abzman/modular-i2c-board-set/README.md

# modular-i2c-board-set
boards designed to be used together to create a modular control system
