abzman/modular-i2c-board-set/i2c BTS7960/i2c BTS7960.kicad_pcb

## KiCad design i2c BTS7960/i2c BTS7960.kicad_pcb (2024-04-11)

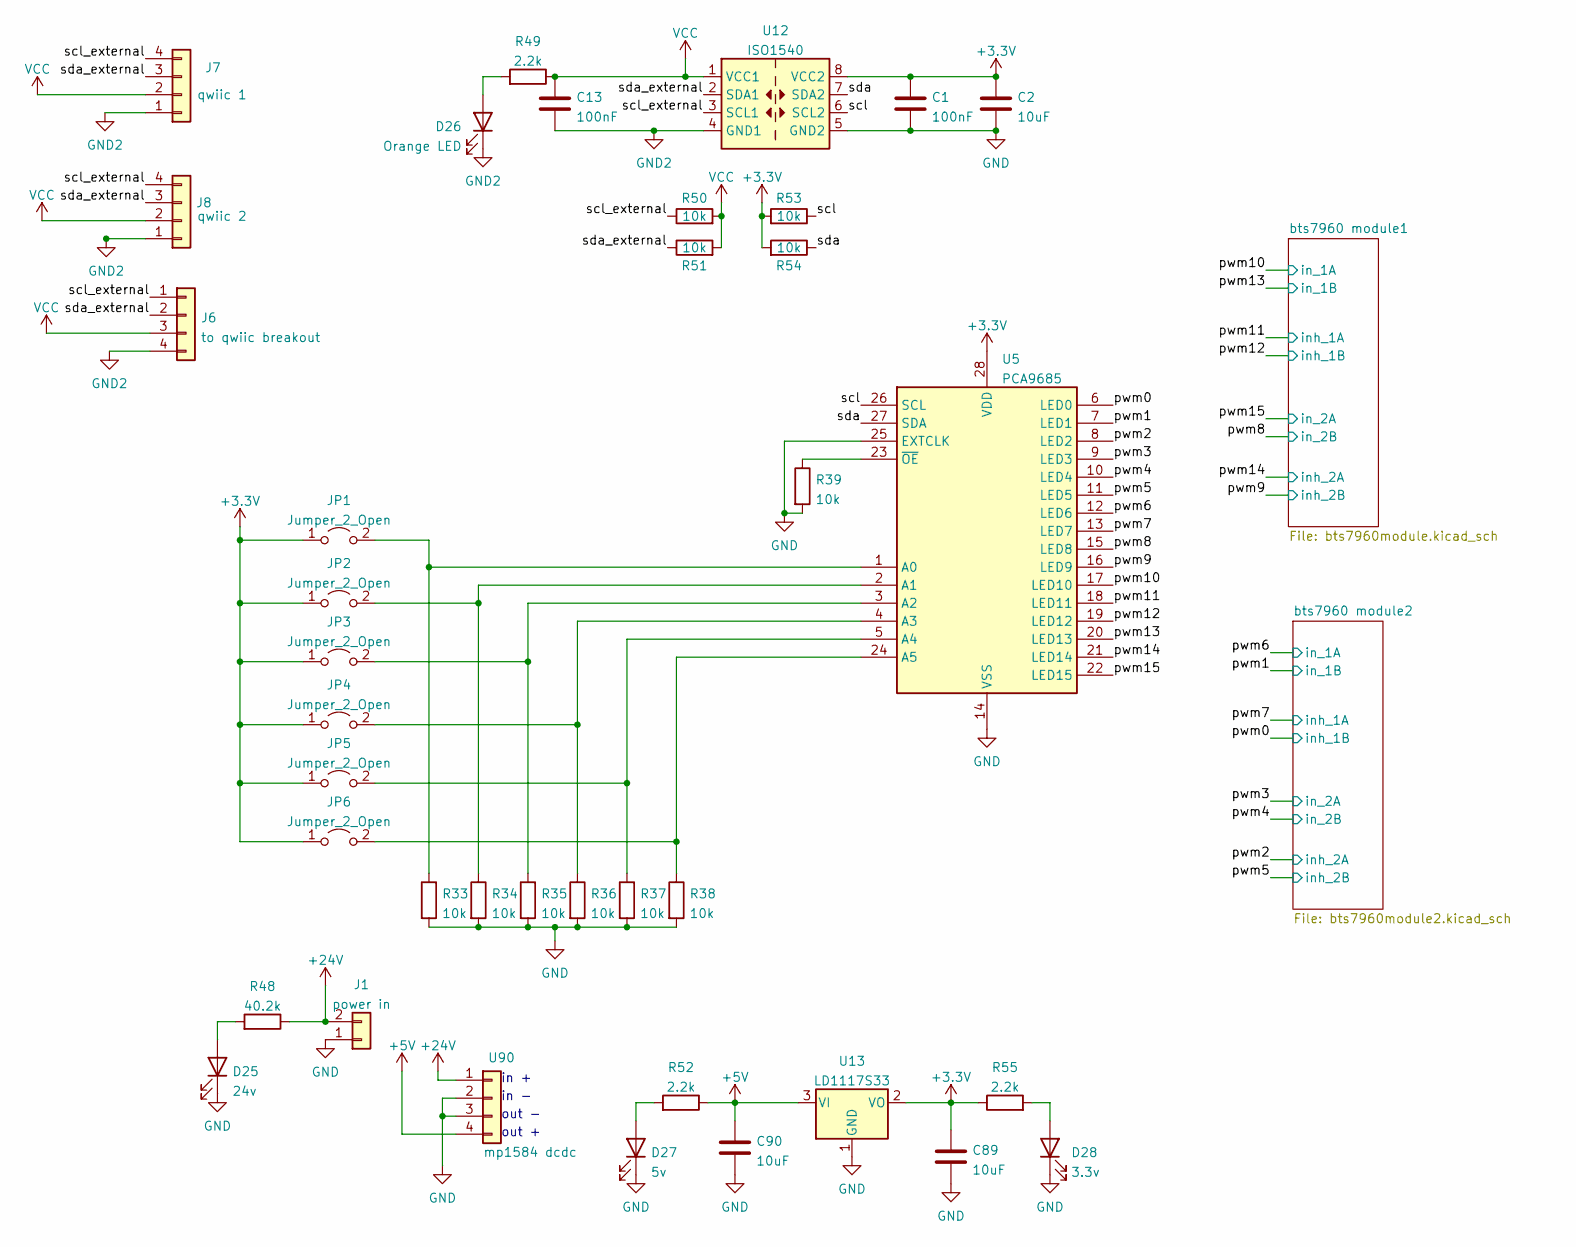
[picture p1: schematic i2c BTS7960.kicad_sch]

Parts:
C1, C13: 100nF; C_0603_1608Metric
C2: 10uF; C_0603_1608Metric
C89, C90: 10uF; C_1206_3216Metric
D25: 24v; LED_0603_1608Metric
D26: Orange LED; LED_0603_1608Metric
D27: 5v; LED_0603_1608Metric
D28: 3.3v; LED_0603_1608Metric
J1: power in; TerminalBlock_Phoenix_MKDS-1,5-2_1x02_P5.00mm_Horizontal
J6: to qwiic breakout; PinHeader_1x04_P2.54mm_Vertical
J7: qwiic 1; JST_SH_SM04B-SRSS-TB_1x04-1MP_P1.00mm_Horizontal
J8: qwiic 2; JST_SH_SM04B-SRSS-TB_1x04-1MP_P1.00mm_Horizontal
JP1, JP2, JP3, JP4, JP5: Jumper_2_Open; SolderJumper-2_P1.3mm_Open_RoundedPad1.0x1.5mm
JP6: Jumper_2_Open; SolderJumper-2_P1.3mm_Bridged_RoundedPad1.0x1.5mm
R33, R34, R35, R36, R37, R38, R39, R50, R51, R53, R54: 10k; R_0603_1608Metric
R48: 40.2k; R_0603_1608Metric
R49, R52, R55: 2.2k; R_0603_1608Metric
U5: PCA9685; TSSOP-28_4.4x9.7mm_P0.65mm
U12: ISO1540; SOIC-8_3.9x4.9mm_P1.27mm
U13: LD1117S33; SOT-223-3_TabPin2
U90: mp1584 dcdc; MP1584_buck_module

Connections:
+3V3: C1.1, C2.1, C89.1, JP1.1 (A), JP2.1 (A), JP3.1 (A), JP4.1 (A), JP5.1 (A), JP6.1 (A), R53.2, R54.2, R55.1, U5.28 (VDD), U12.8 (VCC2), U13.2 (VO)
+5V: C90.1, R52.1, U13.3 (VI), U90.4; also elsewhere on the board
+24V: J1.2, R48.1, U90.1; also elsewhere on the board
/pwm0: U5.6 (LED0); also elsewhere on the board
/pwm1: U5.7 (LED1); also elsewhere on the board
/pwm2: U5.8 (LED2); also elsewhere on the board
/pwm3: U5.9 (LED3); also elsewhere on the board
/pwm4: U5.10 (LED4); also elsewhere on the board
/pwm5: U5.11 (LED5); also elsewhere on the board
/pwm6: U5.12 (LED6); also elsewhere on the board
/pwm7: U5.13 (LED7); also elsewhere on the board
/pwm8: U5.15 (LED8); also elsewhere on the board
/pwm9: U5.16 (LED9); also elsewhere on the board
/pwm10: U5.17 (LED10); also elsewhere on the board
/pwm11: U5.18 (LED11); also elsewhere on the board
/pwm12: U5.19 (LED12); also elsewhere on the board
/pwm13: U5.20 (LED13); also elsewhere on the board
/pwm14: U5.21 (LED14); also elsewhere on the board
/pwm15: U5.22 (LED15); also elsewhere on the board
/scl: R53.1, U5.26 (SCL), U12.6 (SCL2)
/scl_external: J6.1, J7.4, J8.4, R50.1, U12.3 (SCL1)
/sda: R54.1, U5.27 (SDA), U12.7 (SDA2)
/sda_external: J6.2, J7.3, J8.3, R51.1, U12.2 (SDA1)
GND: C1.2, C2.2, C89.2, C90.2, D25.1 (K), D27.1 (K), D28.1 (K), J1.1, J7.MP, J8.MP, R33.2, R34.2, R35.2, R36.2, R37.2, R38.2, R39.2, U5.14 (VSS), U5.25 (EXTCLK), U12.5 (GND2), U13.1 (GND), U90.2, U90.3; also elsewhere on the board
GND2: C13.2, D26.1 (K), J6.4, J7.1, J8.1, U12.4 (GND1)
unnamed: D25.2 (A), R48.2
unnamed: D26.2 (A), R49.2
unnamed: D27.2 (A), R52.2
unnamed: D28.2 (A), R55.2
unnamed: JP1.2 (B), R33.1, U5.1 (A0)
unnamed: JP2.2 (B), R34.1, U5.2 (A1)
unnamed: JP3.2 (B), R35.1, U5.3 (A2)
unnamed: JP4.2 (B), R36.1, U5.4 (A3)
unnamed: JP5.2 (B), R37.1, U5.5 (A4)
unnamed: JP6.2 (B), R38.1, U5.24 (A5)
unnamed: R39.1, U5.23 (~OE)
VCC: C13.1, J6.3, J7.2, J8.2, R49.1, R50.2, R51.2, U12.1 (VCC1)

Notes on the sheet:
in +
out -
out +
in -

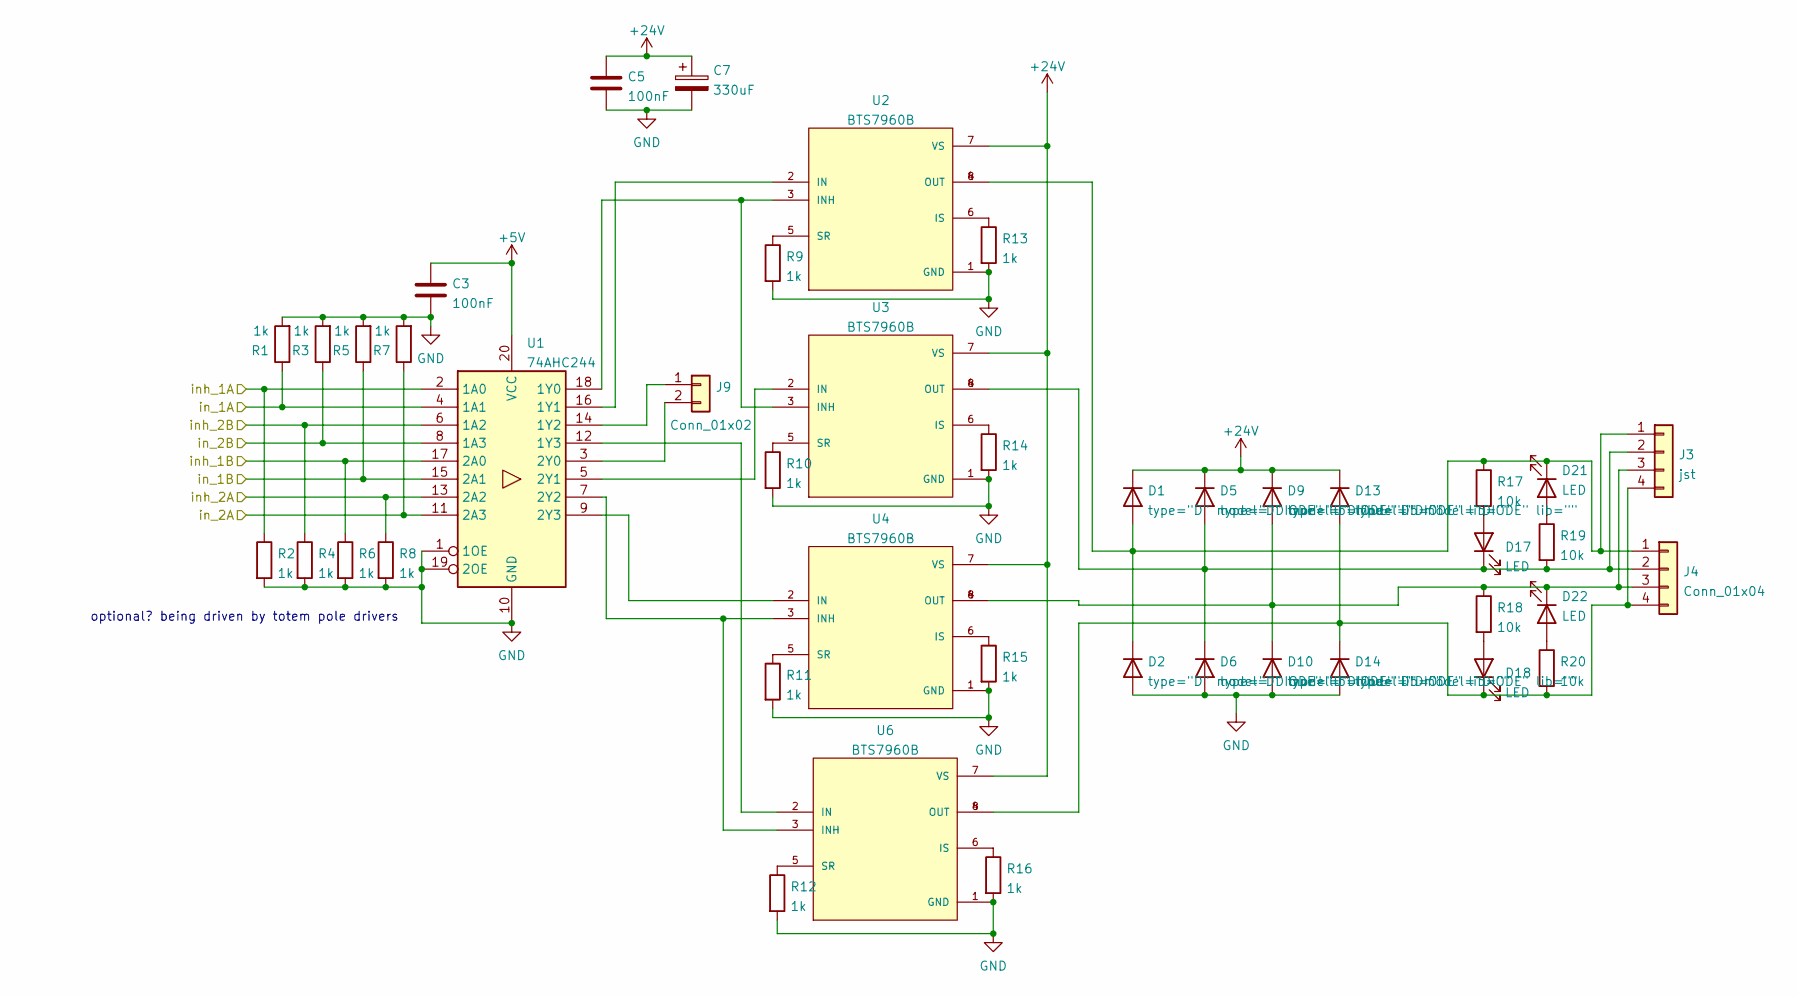
[picture p2: schematic bts7960module2.kicad_sch]

Parts:
C3, C5: 100nF; C_0603_1608Metric
C7: 330uF; CP_Radial_D10.0mm_P5.00mm
D1, D2, D5, D6, D9, D10, D13, D14: type="D" model="DIODE" lib=""; D_SMA
D17, D18, D21, D22: LED; LED_0603_1608Metric
J3: jst; JST_XH_B4B-XH-A_1x04_P2.50mm_Vertical
J4: Conn_01x04; TerminalBlock_Phoenix_MKDS-1,5-4_1x04_P5.00mm_Horizontal
J9: Conn_01x02; PinHeader_2x01_P2.54mm_Vertical
R1, R2, R3, R4, R5, R6, R7, R8, R9, R10, R11, R12, R13, R14, R15, R16: 1k; R_0603_1608Metric
R17, R18, R19, R20: 10k; R_0603_1608Metric
U1: 74AHC244; SOIC-20W_7.5x12.8mm_P1.27mm
U2, U3, U4, U6: BTS7960B; DPAK127P1490X440-8N; PARTREV 1.1

Connections:
+5V: C3.1, U1.20 (VCC); also elsewhere on the board
+24V: C5.1, C7.1, D1.2 (K), D5.2 (K), D9.2 (K), D13.2 (K), U2.7 (VS), U3.7 (VS), U4.7 (VS), U6.7 (VS); also elsewhere on the board
/pwm0: R6.1, U1.17 (2A0); also elsewhere on the board
/pwm1: R5.1, U1.15 (2A1); also elsewhere on the board
/pwm2: R8.1, U1.13 (2A2); also elsewhere on the board
/pwm3: R7.1, U1.11 (2A3); also elsewhere on the board
/pwm4: R3.1, U1.8 (1A3); also elsewhere on the board
/pwm5: R4.1, U1.6 (1A2); also elsewhere on the board
/pwm6: R1.1, U1.4 (1A1); also elsewhere on the board
/pwm7: R2.1, U1.2 (1A0); also elsewhere on the board
GND: C3.2, C5.2, C7.2, D2.1 (A), D6.1 (A), D10.1 (A), D14.1 (A), R1.2, R2.2, R3.2, R4.2, R5.2, R6.2, R7.2, R8.2, R9.2, R10.2, R11.2, R12.2, R13.2, R14.2, R15.2, R16.2, U1.1 (1OE), U1.10 (GND), U1.19 (2OE), U2.1 (GND), U3.1 (GND), U4.1 (GND), U6.1 (GND); also elsewhere on the board
unnamed: D1.1 (A), D2.2 (K), D21.1 (K), J3.1, J4.1, R17.1, U2.4 (OUT), U2.8 (OUT)
unnamed: D9.1 (A), D10.2 (K), D22.1 (K), J3.3, J4.3, R18.1, U4.4 (OUT), U4.8 (OUT)
unnamed: D13.1 (A), D14.2 (K), D18.1 (K), J3.4, J4.4, R20.2, U6.4 (OUT), U6.8 (OUT)
unnamed: D17.2 (A), R17.2
unnamed: D5.1 (A), D6.2 (K), D17.1 (K), J3.2, J4.2, R19.2, U3.4 (OUT), U3.8 (OUT)
unnamed: D18.2 (A), R18.2
unnamed: D21.2 (A), R19.1
unnamed: D22.2 (A), R20.1
unnamed: J9.1, U1.14 (1Y2)
unnamed: J9.2, U1.3 (2Y0)
unnamed: U1.18 (1Y0), U2.3 (INH), U3.3 (INH)
unnamed: U1.16 (1Y1), U2.2 (IN)
unnamed: U1.12 (1Y3), U6.2 (IN)
unnamed: U1.5 (2Y1), U3.2 (IN)
unnamed: U1.7 (2Y2), U4.3 (INH), U6.3 (INH)
unnamed: U1.9 (2Y3), U4.2 (IN)
unnamed: R13.1, U2.6 (IS)
unnamed: R9.1, U2.5 (SR)
unnamed: R14.1, U3.6 (IS)
unnamed: R10.1, U3.5 (SR)
unnamed: R15.1, U4.6 (IS)
unnamed: R11.1, U4.5 (SR)
unnamed: R16.1, U6.6 (IS)
unnamed: R12.1, U6.5 (SR)

Notes on the sheet:
optional? being driven by totem pole drivers

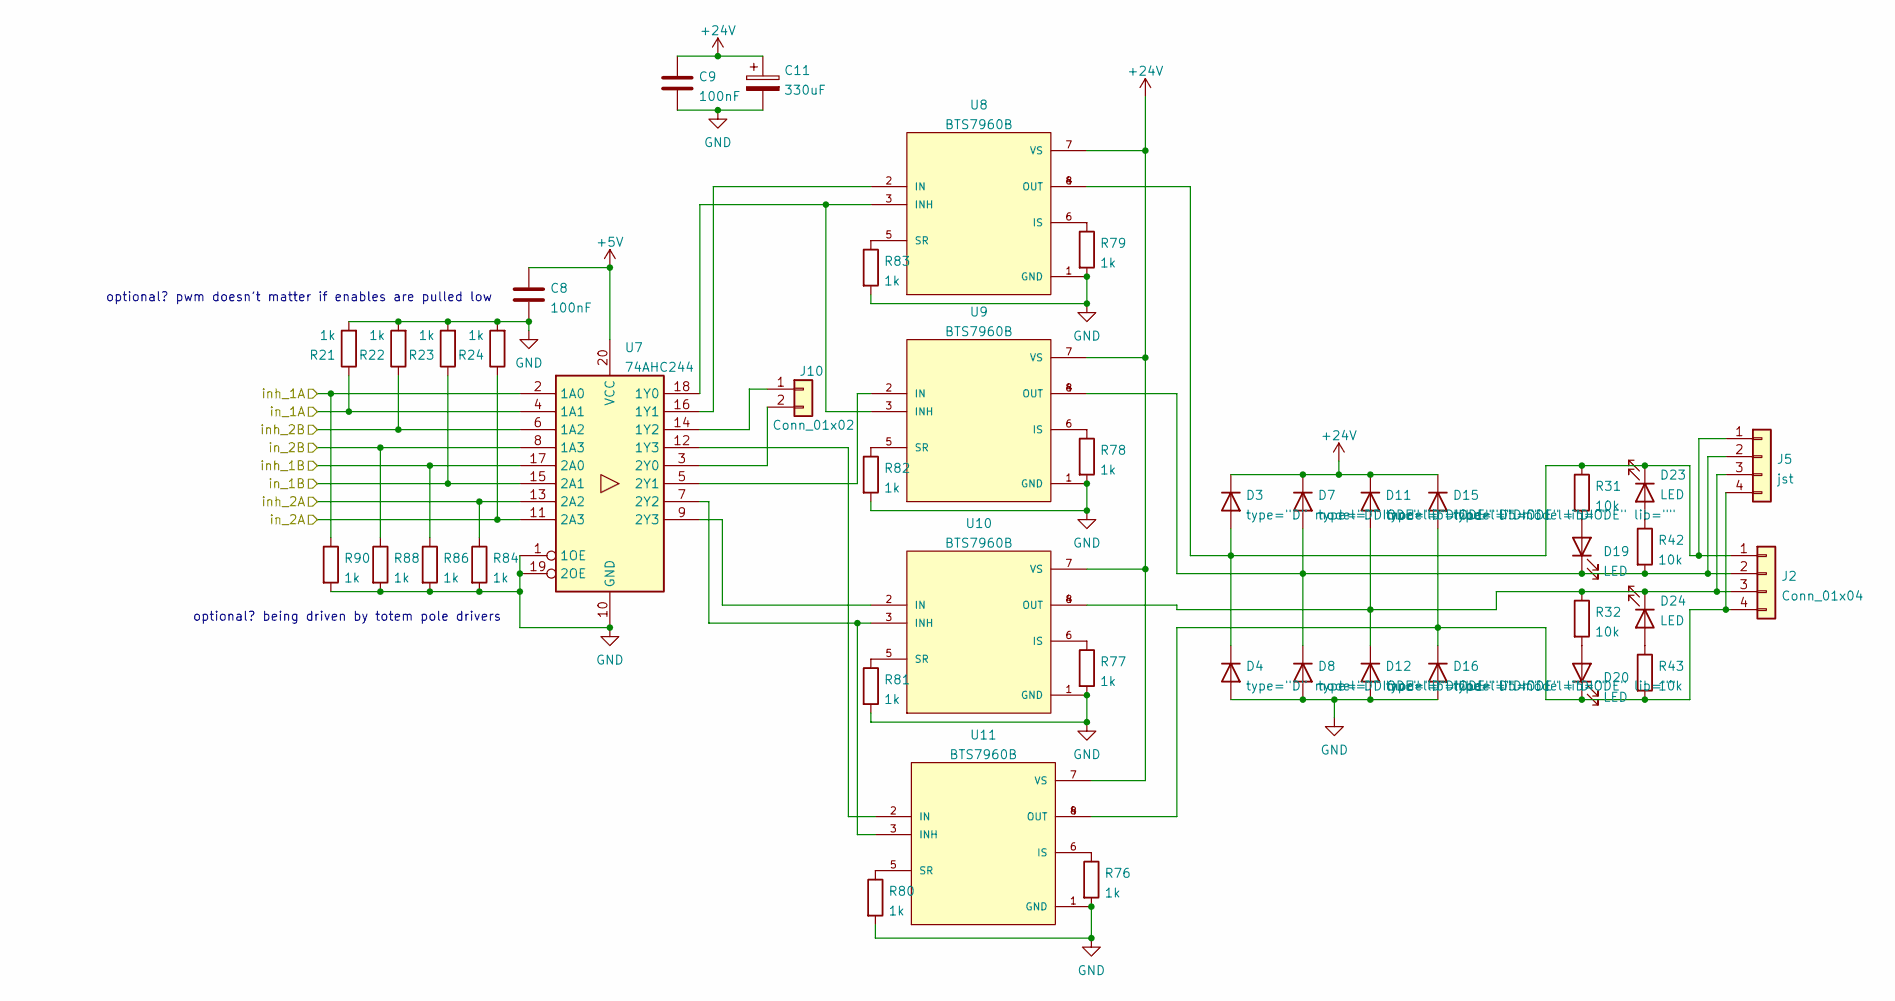
[picture p3: schematic bts7960module.kicad_sch]

Parts:
C8, C9: 100nF; C_0603_1608Metric
C11: 330uF; CP_Radial_D10.0mm_P5.00mm
D3, D4, D7, D8, D11, D12, D15, D16: type="D" model="DIODE" lib=""; D_SMA
D19, D20, D23, D24: LED; LED_0603_1608Metric
J2: Conn_01x04; TerminalBlock_Phoenix_MKDS-1,5-4_1x04_P5.00mm_Horizontal
J5: jst; JST_XH_B4B-XH-A_1x04_P2.50mm_Vertical
J10: Conn_01x02; PinHeader_2x01_P2.54mm_Vertical
R21, R22, R23, R24, R76, R77, R78, R79, R80, R81, R82, R83, R84, R86, R88, R90: 1k; R_0603_1608Metric
R31, R32, R42, R43: 10k; R_0603_1608Metric
U7: 74AHC244; SOIC-20W_7.5x12.8mm_P1.27mm
U8, U9, U10, U11: BTS7960B; DPAK127P1490X440-8N; PARTREV 1.1

Connections:
+5V: C8.1, U7.20 (VCC); also elsewhere on the board
+24V: C9.1, C11.1, D3.2 (K), D7.2 (K), D11.2 (K), D15.2 (K), U8.7 (VS), U9.7 (VS), U10.7 (VS), U11.7 (VS); also elsewhere on the board
/pwm8: R88.1, U7.8 (1A3); also elsewhere on the board
/pwm9: R22.1, U7.6 (1A2); also elsewhere on the board
/pwm10: R21.1, U7.4 (1A1); also elsewhere on the board
/pwm11: R90.1, U7.2 (1A0); also elsewhere on the board
/pwm12: R86.1, U7.17 (2A0); also elsewhere on the board
/pwm13: R23.1, U7.15 (2A1); also elsewhere on the board
/pwm14: R84.1, U7.13 (2A2); also elsewhere on the board
/pwm15: R24.1, U7.11 (2A3); also elsewhere on the board
GND: C8.2, C9.2, C11.2, D4.1 (A), D8.1 (A), D12.1 (A), D16.1 (A), R21.2, R22.2, R23.2, R24.2, R76.2, R77.2, R78.2, R79.2, R80.2, R81.2, R82.2, R83.2, R84.2, R86.2, R88.2, R90.2, U7.1 (1OE), U7.10 (GND), U7.19 (2OE), U8.1 (GND), U9.1 (GND), U10.1 (GND), U11.1 (GND); also elsewhere on the board
unnamed: D11.1 (A), D12.2 (K), D24.1 (K), J2.3, J5.3, R32.1, U10.4 (OUT), U10.8 (OUT)
unnamed: D15.1 (A), D16.2 (K), D20.1 (K), J2.4, J5.4, R43.2, U11.4 (OUT), U11.8 (OUT)
unnamed: D19.2 (A), R31.2
unnamed: D7.1 (A), D8.2 (K), D19.1 (K), J2.2, J5.2, R42.2, U9.4 (OUT), U9.8 (OUT)
unnamed: D20.2 (A), R32.2
unnamed: D23.2 (A), R42.1
unnamed: D3.1 (A), D4.2 (K), D23.1 (K), J2.1, J5.1, R31.1, U8.4 (OUT), U8.8 (OUT)
unnamed: D24.2 (A), R43.1
unnamed: J10.1, U7.14 (1Y2)
unnamed: J10.2, U7.3 (2Y0)
unnamed: U7.18 (1Y0), U8.3 (INH), U9.3 (INH)
unnamed: U7.16 (1Y1), U8.2 (IN)
unnamed: U7.5 (2Y1), U9.2 (IN)
unnamed: R79.1, U8.6 (IS)
unnamed: R83.1, U8.5 (SR)
unnamed: R78.1, U9.6 (IS)
unnamed: R82.1, U9.5 (SR)
unnamed: U7.9 (2Y3), U10.2 (IN)
unnamed: U7.7 (2Y2), U10.3 (INH), U11.3 (INH)
unnamed: R77.1, U10.6 (IS)
unnamed: R81.1, U10.5 (SR)
unnamed: U7.12 (1Y3), U11.2 (IN)
unnamed: R76.1, U11.6 (IS)
unnamed: R80.1, U11.5 (SR)

Notes on the sheet:
optional? pwm doesn't matter if enables are pulled low
optional? being driven by totem pole drivers

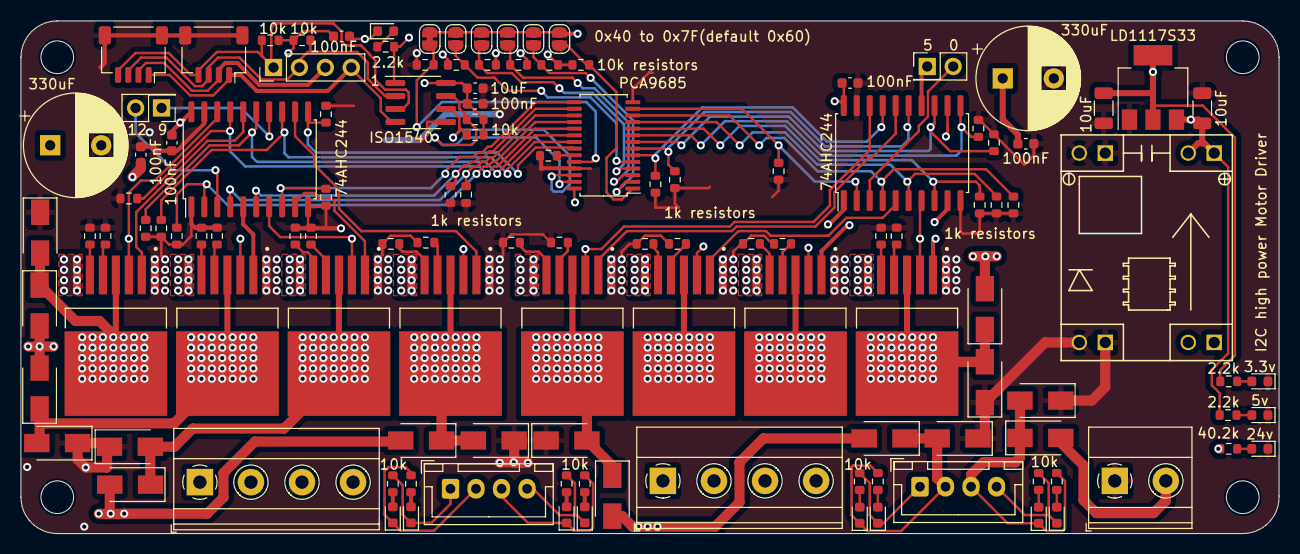
[picture p4: board i2c BTS7960.kicad_pcb from above]

Board: 4 copper layers, 123.2 x 50.2 mm, 124 parts (0 on the bottom side), 85 nets.
