abzman/modular-i2c-board-set/i2c 24vout/i2c 24vout.kicad_pcb

## KiCad design i2c 24vout/i2c 24vout.kicad_pcb (2024-04-10)

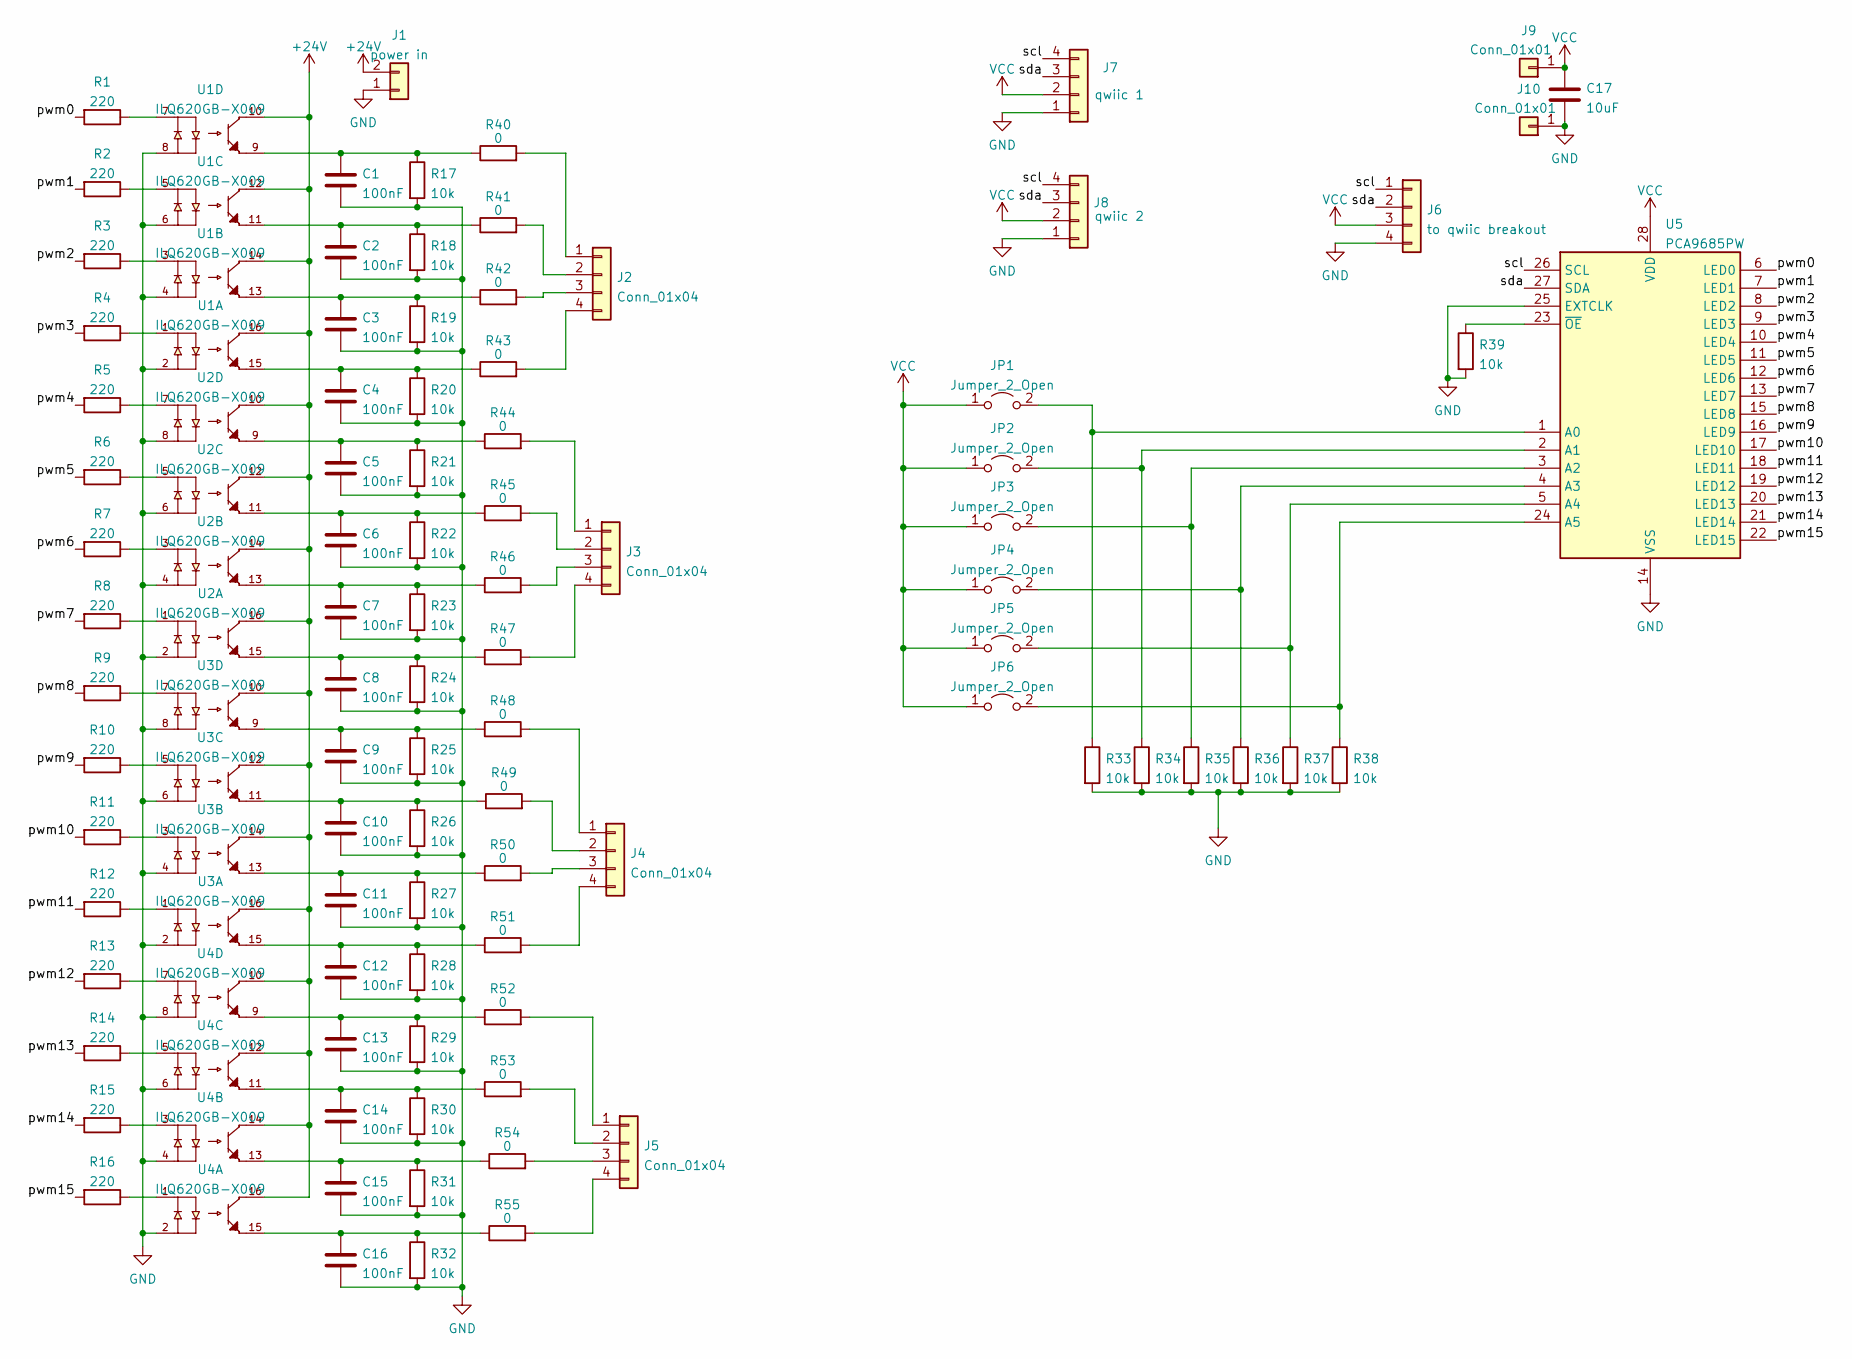
[picture p5: schematic i2c 24vout.kicad_sch]

Parts:
C1, C2, C3, C4, C5, C6, C7, C8, C9, C10, C11, C12, C13, C14, C15, C16: 100nF; C_0603_1608Metric
C17: 10uF; C_0603_1608Metric
J1: power in; TerminalBlock_Phoenix_MKDS-1,5-2_1x02_P5.00mm_Horizontal
J2, J3, J4, J5: Conn_01x04; TerminalBlock_Phoenix_MKDS-1,5-4_1x04_P5.00mm_Horizontal
J6: to qwiic breakout; PinHeader_1x04_P2.54mm_Vertical
J7: qwiic 1; JST_SH_SM04B-SRSS-TB_1x04-1MP_P1.00mm_Horizontal
J8: qwiic 2; JST_SH_SM04B-SRSS-TB_1x04-1MP_P1.00mm_Horizontal
J9, J10: Conn_01x01; PinHeader_1x01_P2.54mm_Vertical
JP1, JP2, JP3, JP4, JP5, JP6: Jumper_2_Open; SolderJumper-2_P1.3mm_Open_RoundedPad1.0x1.5mm
R1, R2, R3, R4, R5, R6, R7, R8, R9, R10, R11, R12, R13, R14, R15, R16: 220; R_0603_1608Metric
R17, R18, R19, R20, R21, R22, R23, R24, R25, R26, R27, R28, R29, R30, R31, R32, R33, R34, R35, R36, R37, R38, R39: 10k; R_0603_1608Metric
R40, R41, R42, R43, R44, R45, R46, R47, R48, R49, R50, R51, R52, R53, R54, R55: 0; R_0603_1608Metric
U1, U2, U3, U4: ILQ620GB-X009; OPTO_ILQ620GB-X009; PARTREV 1.8
U5: PCA9685PW; TSSOP-28_4.4x9.7mm_P0.65mm

Connections:
+24V: J1.2, U1.10, U1.12, U1.14, U1.16, U2.10, U2.12, U2.14, U2.16, U3.10, U3.12, U3.14, U3.16, U4.10, U4.12, U4.14, U4.16
/pwm0: R1.2, U5.6 (LED0)
/pwm1: R2.2, U5.7 (LED1)
/pwm2: R3.2, U5.8 (LED2)
/pwm3: R4.2, U5.9 (LED3)
/pwm4: R5.2, U5.10 (LED4)
/pwm5: R6.2, U5.11 (LED5)
/pwm6: R7.2, U5.12 (LED6)
/pwm7: R8.2, U5.13 (LED7)
/pwm8: R9.2, U5.15 (LED8)
/pwm9: R10.2, U5.16 (LED9)
/pwm10: R11.2, U5.17 (LED10)
/pwm11: R12.2, U5.18 (LED11)
/pwm12: R13.2, U5.19 (LED12)
/pwm13: R14.2, U5.20 (LED13)
/pwm14: R15.2, U5.21 (LED14)
/pwm15: R16.2, U5.22 (LED15)
/scl: J6.1, J7.4, J8.4, U5.26 (SCL)
/sda: J6.2, J7.3, J8.3, U5.27 (SDA)
GND: C1.2, C2.2, C3.2, C4.2, C5.2, C6.2, C7.2, C8.2, C9.2, C10.2, C11.2, C12.2, C13.2, C14.2, C15.2, C16.2, C17.2, J1.1, J6.4, J7.1, J7.MP, J8.1, J8.MP, J10.1, R17.2, R18.2, R19.2, R20.2, R21.2, R22.2, R23.2, R24.2, R25.2, R26.2, R27.2, R28.2, R29.2, R30.2, R31.2, R32.2, R33.2, R34.2, R35.2, R36.2, R37.2, R38.2, R39.2, U1.2, U1.4, U1.6, U1.8, U2.2, U2.4, U2.6, U2.8, U3.2, U3.4, U3.6, U3.8, U4.2, U4.4, U4.6, U4.8, U5.14 (VSS), U5.25 (EXTCLK)
unnamed: C1.1, R17.1, R40.1, U1.9
unnamed: C2.1, R18.1, R41.1, U1.11
unnamed: C3.1, R19.1, R42.1, U1.13
unnamed: C4.1, R20.1, R43.1, U1.15
unnamed: C5.1, R21.1, R44.1, U2.9
unnamed: C6.1, R22.1, R45.1, U2.11
unnamed: C7.1, R23.1, R46.1, U2.13
unnamed: C8.1, R24.1, R47.1, U2.15
unnamed: C9.1, R25.1, R48.1, U3.9
unnamed: C10.1, R26.1, R49.1, U3.11
unnamed: C11.1, R27.1, R50.1, U3.13
unnamed: C12.1, R28.1, R51.1, U3.15
unnamed: C13.1, R29.1, R52.1, U4.9
unnamed: C14.1, R30.1, R53.1, U4.11
unnamed: C15.1, R31.1, R54.1, U4.13
unnamed: C16.1, R32.1, R55.1, U4.15
unnamed: J2.1, R40.2
unnamed: J2.2, R41.2
unnamed: J2.3, R42.2
unnamed: J2.4, R43.2
unnamed: J3.1, R44.2
unnamed: J3.2, R45.2
unnamed: J3.3, R46.2
unnamed: J3.4, R47.2
unnamed: J4.1, R48.2
unnamed: J4.2, R49.2
unnamed: J4.3, R50.2
unnamed: J4.4, R51.2
unnamed: J5.1, R52.2
unnamed: J5.2, R53.2
unnamed: J5.3, R54.2
unnamed: J5.4, R55.2
unnamed: JP1.2 (B), R33.1, U5.1 (A0)
unnamed: JP2.2 (B), R34.1, U5.2 (A1)
unnamed: JP3.2 (B), R35.1, U5.3 (A2)
unnamed: JP4.2 (B), R36.1, U5.4 (A3)
unnamed: JP5.2 (B), R37.1, U5.5 (A4)
unnamed: JP6.2 (B), R38.1, U5.24 (A5)
unnamed: R1.1, U1.7
unnamed: R2.1, U1.5
unnamed: R3.1, U1.3
unnamed: R4.1, U1.1
unnamed: R5.1, U2.7
unnamed: R6.1, U2.5
unnamed: R7.1, U2.3
unnamed: R8.1, U2.1
unnamed: R9.1, U3.7
unnamed: R10.1, U3.5
unnamed: R11.1, U3.3
unnamed: R12.1, U3.1
unnamed: R13.1, U4.7
unnamed: R14.1, U4.5
unnamed: R15.1, U4.3
unnamed: R16.1, U4.1
unnamed: R39.1, U5.23 (~OE)
VCC: C17.1, J6.3, J7.2, J8.2, J9.1, JP1.1 (A), JP2.1 (A), JP3.1 (A), JP4.1 (A), JP5.1 (A), JP6.1 (A), U5.28 (VDD)

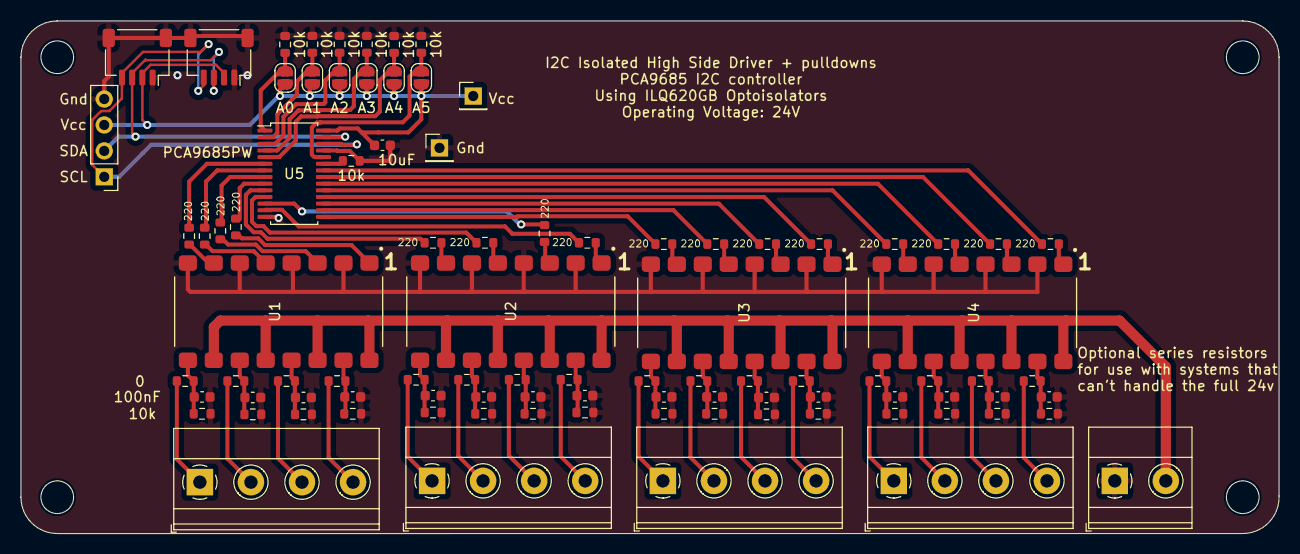
[picture p6: board i2c 24vout.kicad_pcb from above]

Board: 2 copper layers, 123.2 x 50.2 mm, 93 parts (0 on the bottom side), 76 nets.
