abzman/modular-i2c-board-set/i2c 24vin/i2c 24vin.kicad_pcb

## KiCad design i2c 24vin/i2c 24vin.kicad_pcb (2024-04-10)

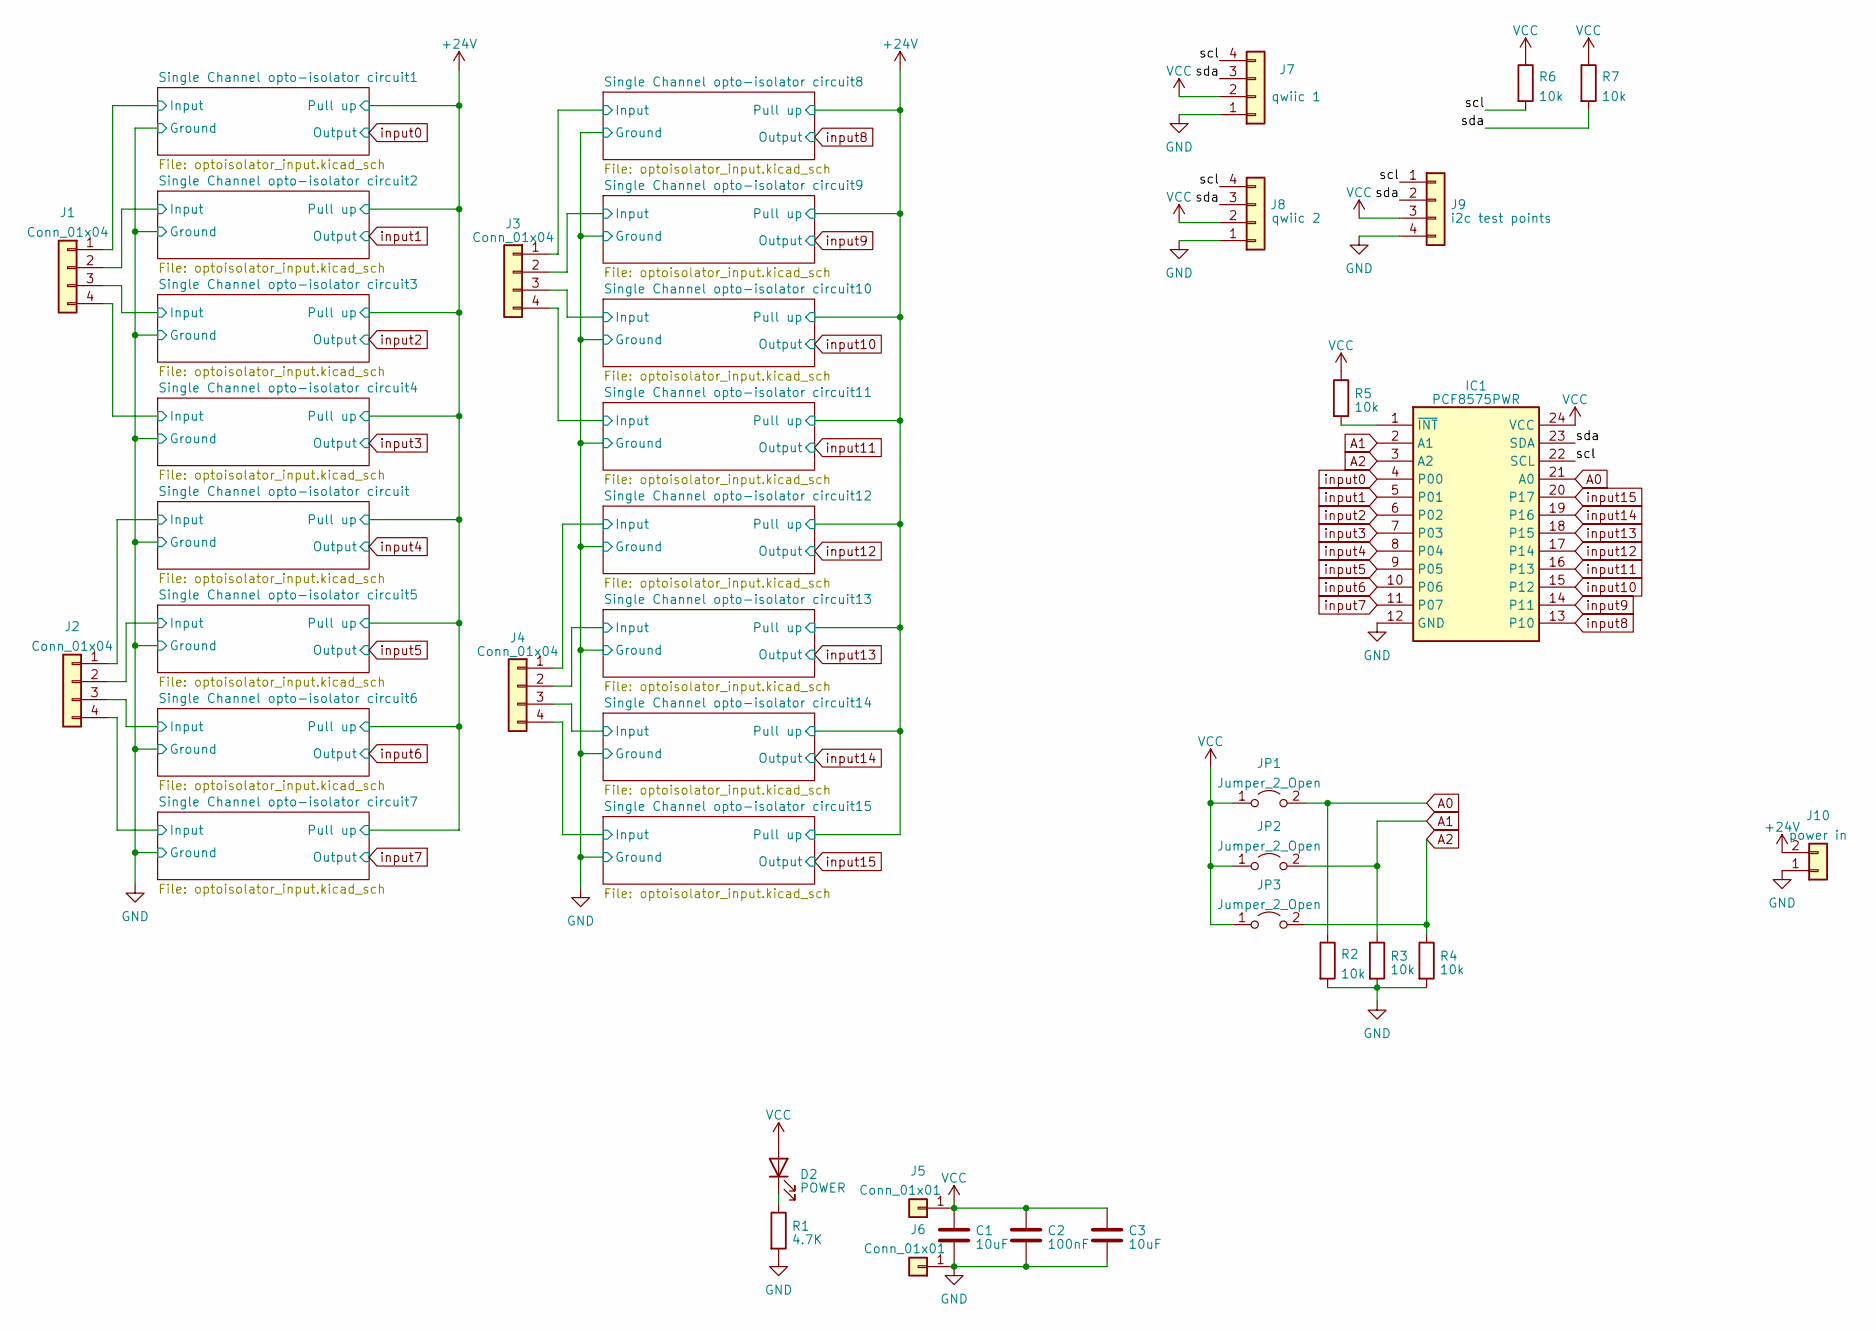
[picture p7: schematic i2c 24vin.kicad_sch]

Parts:
C1, C3: 10uF; C_0603_1608Metric
C2: 100nF; C_0603_1608Metric
D2: POWER; LED_0603_1608Metric_Pad1.05x0.95mm_HandSolder
IC1: PCF8575PWR; SOP65P640X120-24N; Mouser Part Number 595-PCF8575PWR
J1, J2, J3, J4: Conn_01x04; TerminalBlock_Phoenix_MKDS-1,5-4_1x04_P5.00mm_Horizontal
J5, J6: Conn_01x01; PinHeader_1x01_P2.54mm_Vertical
J7: qwiic 1; JST_SH_SM04B-SRSS-TB_1x04-1MP_P1.00mm_Horizontal
J8: qwiic 2; JST_SH_SM04B-SRSS-TB_1x04-1MP_P1.00mm_Horizontal
J9: i2c test points; PinHeader_1x04_P2.54mm_Vertical
J10: power in; TerminalBlock_Phoenix_MKDS-1,5-2_1x02_P5.00mm_Horizontal
JP1, JP2, JP3: Jumper_2_Open; SolderJumper-2_P1.3mm_Open_RoundedPad1.0x1.5mm
R1: 4.7K; R_0603_1608Metric
R2, R3, R4, R5, R6, R7: 10k; R_0603_1608Metric

Connections:
+24V: J10.2; also elsewhere on the board
/Single Channel opto-isolator circuit1/Input: J1.1; also elsewhere on the board
/Single Channel opto-isolator circuit2/Input: J1.2; also elsewhere on the board
/Single Channel opto-isolator circuit3/Input: J1.3; also elsewhere on the board
/Single Channel opto-isolator circuit4/Input: J1.4; also elsewhere on the board
/Single Channel opto-isolator circuit5/Input: J2.2; also elsewhere on the board
/Single Channel opto-isolator circuit6/Input: J2.3; also elsewhere on the board
/Single Channel opto-isolator circuit7/Input: J2.4; also elsewhere on the board
/Single Channel opto-isolator circuit8/Input: J3.1; also elsewhere on the board
/Single Channel opto-isolator circuit9/Input: J3.2; also elsewhere on the board
/Single Channel opto-isolator circuit10/Input: J3.3; also elsewhere on the board
/Single Channel opto-isolator circuit11/Input: J3.4; also elsewhere on the board
/Single Channel opto-isolator circuit12/Input: J4.1; also elsewhere on the board
/Single Channel opto-isolator circuit13/Input: J4.2; also elsewhere on the board
/Single Channel opto-isolator circuit14/Input: J4.3; also elsewhere on the board
/Single Channel opto-isolator circuit15/Input: J4.4; also elsewhere on the board
/scl: IC1.22 (SCL), J7.4, J8.4, J9.1, R6.2
/sda: IC1.23 (SDA), J7.3, J8.3, J9.2, R7.2
A0: IC1.21 (A0), JP1.2 (B), R2.1
A1: IC1.2 (A1), JP2.2 (B), R3.1
A2: IC1.3 (A2), JP3.2 (B), R4.1
GND: C1.2, C2.2, C3.2, IC1.12 (GND), J6.1, J7.1, J7.MP, J8.1, J8.MP, J9.4, J10.1, R1.2, R2.2, R3.2, R4.2; also elsewhere on the board
unnamed: IC1.1 (~INT), R5.2
input0: IC1.4 (P00); also elsewhere on the board
input1: IC1.5 (P01); also elsewhere on the board
input2: IC1.6 (P02); also elsewhere on the board
input3: IC1.7 (P03); also elsewhere on the board
input4: IC1.8 (P04); also elsewhere on the board
input5: IC1.9 (P05); also elsewhere on the board
input6: IC1.10 (P06); also elsewhere on the board
input7: IC1.11 (P07); also elsewhere on the board
input8: IC1.13 (P10); also elsewhere on the board
input9: IC1.14 (P11); also elsewhere on the board
input10: IC1.15 (P12); also elsewhere on the board
input11: IC1.16 (P13); also elsewhere on the board
input12: IC1.17 (P14); also elsewhere on the board
input13: IC1.18 (P15); also elsewhere on the board
input14: IC1.19 (P16); also elsewhere on the board
input15: IC1.20 (P17); also elsewhere on the board

Parts of its further copies:
D1: POWER; LED_0603_1608Metric_Pad1.05x0.95mm_HandSolder
