abzman/modular-i2c-board-set/i2c 24vin/i2c 24vin.kicad_pcb

## KiCad design i2c 24vin/i2c 24vin.kicad_pcb (continued)

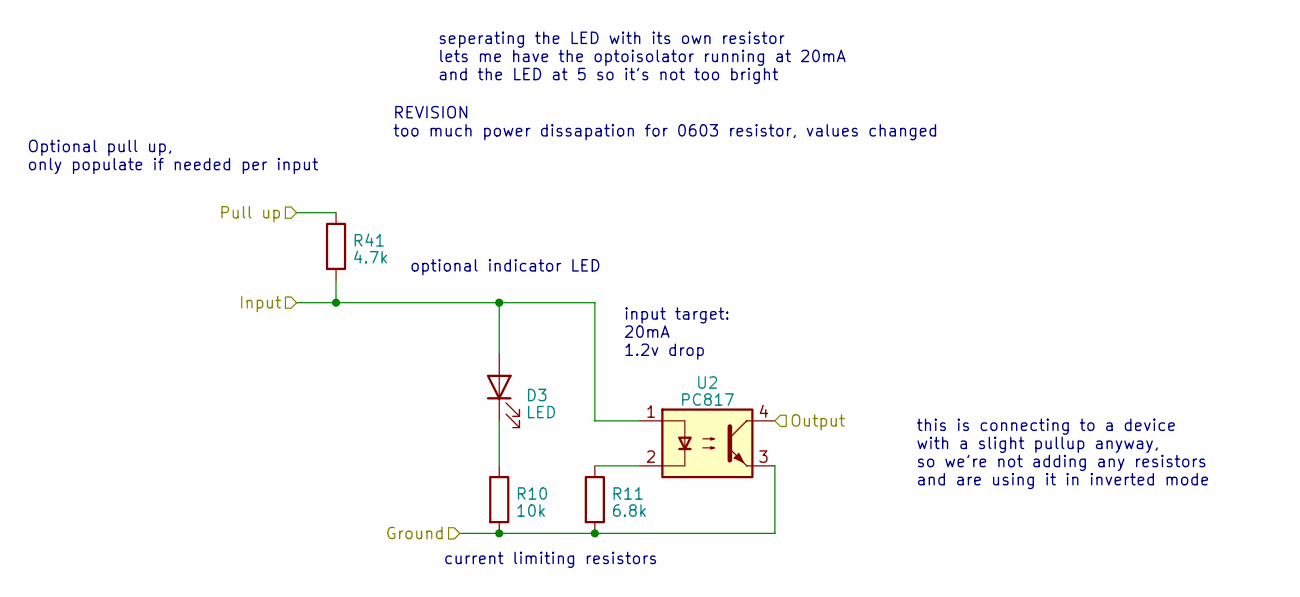
[picture p8: schematic optoisolator_input.kicad_sch]

Parts:
D3: LED; LED_0603_1608Metric_Pad1.05x0.95mm_HandSolder
R10: 10k; R_0603_1608Metric
R11: 6.8k; R_0603_1608Metric
R41: 4.7k; R_0603_1608Metric
U2: PC817; DIP-4_W7.62mm

Connections:
+24V: R41.1; also elsewhere on the board
/Single Channel opto-isolator circuit1/Input: D3.2 (A), R41.2, U2.1; also elsewhere on the board
GND: R10.2, R11.2, U2.3; also elsewhere on the board
unnamed: D3.1 (K), R10.1
unnamed: R11.1, U2.2
input0: U2.4; also elsewhere on the board

Parts of its further copies:
D4, D5, D6, D7, D8, D9, D10, D11, D12, D13, D14, D15, D16, D17: LED; LED_0603_1608Metric_Pad1.05x0.95mm_HandSolder
R8, R12, R14, R16, R18, R20, R22, R24, R26, R28, R30, R32, R34, R36, R38: 10k; R_0603_1608Metric
R9, R13, R15, R17, R19, R21, R23, R25, R27, R29, R31, R33, R35, R37, R39: 6.8k; R_0603_1608Metric
R40, R42, R43, R44, R45, R46, R47, R48, R49, R50, R51, R52, R53, R54, R55: 4.7k; R_0603_1608Metric
U1, U3, U4, U5, U6, U7, U8, U9, U10, U11, U12, U13, U14, U15, U16: PC817; DIP-4_W7.62mm

Connections of its further copies:
+24V: R40.1, R42.1, R43.1, R44.1, R45.1, R46.1, R47.1, R48.1, R49.1, R50.1, R51.1, R52.1, R53.1, R54.1, R55.1; also elsewhere on the board
/Single Channel opto-isolator circuit2/Input: D4.2 (A), R42.2, U3.1; also elsewhere on the board
/Single Channel opto-isolator circuit3/Input: D5.2 (A), R43.2, U4.1; also elsewhere on the board
/Single Channel opto-isolator circuit4/Input: D6.2 (A), R44.2, U5.1; also elsewhere on the board
/Single Channel opto-isolator circuit5/Input: D7.2 (A), R45.2, U6.1; also elsewhere on the board
/Single Channel opto-isolator circuit6/Input: D8.2 (A), R46.2, U7.1; also elsewhere on the board
/Single Channel opto-isolator circuit7/Input: D9.2 (A), R47.2, U8.1; also elsewhere on the board
/Single Channel opto-isolator circuit8/Input: D11.2 (A), R49.2, U10.1; also elsewhere on the board
/Single Channel opto-isolator circuit9/Input: D12.2 (A), R50.2, U11.1; also elsewhere on the board
/Single Channel opto-isolator circuit10/Input: D13.2 (A), R51.2, U12.1; also elsewhere on the board
/Single Channel opto-isolator circuit11/Input: D14.2 (A), R52.2, U13.1; also elsewhere on the board
/Single Channel opto-isolator circuit12/Input: D10.2 (A), R48.2, U9.1; also elsewhere on the board
/Single Channel opto-isolator circuit13/Input: D15.2 (A), R53.2, U14.1; also elsewhere on the board
/Single Channel opto-isolator circuit14/Input: D16.2 (A), R54.2, U15.1; also elsewhere on the board
/Single Channel opto-isolator circuit15/Input: D17.2 (A), R55.2, U16.1; also elsewhere on the board
GND: R8.2, R9.2, R12.2, R13.2, R14.2, R15.2, R16.2, R17.2, R18.2, R19.2, R20.2, R21.2, R22.2, R23.2, R24.2, R25.2, R26.2, R27.2, R28.2, R29.2, R30.2, R31.2, R32.2, R33.2, R34.2, R35.2, R36.2, R37.2, R38.2, R39.2, U1.3, U3.3, U4.3, U5.3, U6.3, U7.3, U8.3, U9.3, U10.3, U11.3, U12.3, U13.3, U14.3, U15.3, U16.3; also elsewhere on the board
unnamed: D4.1 (K), R12.1
unnamed: D5.1 (K), R14.1
unnamed: D6.1 (K), R16.1
unnamed: D7.1 (K), R18.1
unnamed: D8.1 (K), R20.1
unnamed: D9.1 (K), R22.1
unnamed: D10.1 (K), R24.1
unnamed: D11.1 (K), R26.1
unnamed: D12.1 (K), R28.1
unnamed: D13.1 (K), R30.1
unnamed: D14.1 (K), R32.1
unnamed: D15.1 (K), R34.1
unnamed: D16.1 (K), R36.1
unnamed: D17.1 (K), R38.1
unnamed: R9.1, U1.2
unnamed: R13.1, U3.2
unnamed: R15.1, U4.2
unnamed: R17.1, U5.2
unnamed: R19.1, U6.2
unnamed: R21.1, U7.2
unnamed: R23.1, U8.2
unnamed: R25.1, U9.2
unnamed: R27.1, U10.2
unnamed: R29.1, U11.2
unnamed: R31.1, U12.2
unnamed: R33.1, U13.2
unnamed: R35.1, U14.2
unnamed: R37.1, U15.2
unnamed: R39.1, U16.2
input1: U3.4; also elsewhere on the board
input2: U4.4; also elsewhere on the board
input3: U5.4; also elsewhere on the board
input4: U1.4; also elsewhere on the board
input5: U6.4; also elsewhere on the board
input6: U7.4; also elsewhere on the board
input7: U8.4; also elsewhere on the board
input8: U10.4; also elsewhere on the board
input9: U11.4; also elsewhere on the board
input10: U12.4; also elsewhere on the board
input11: U13.4; also elsewhere on the board
input12: U9.4; also elsewhere on the board
input13: U14.4; also elsewhere on the board
input14: U15.4; also elsewhere on the board
input15: U16.4; also elsewhere on the board

Notes on the sheet:
this is connecting to a device with a slight pullup anyway, so we're not adding any resistors and are using it in inverted mode
input target: 20mA 1.2v drop
Optional pull up, only populate if needed per input
current limiting resistors
seperating the LED with its own resistor lets me have the optoisolator running at 20mA and the LED at 5 so it's not too bright
REVISION too much power dissapation for 0603 resistor, values changed
optional indicator LED

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
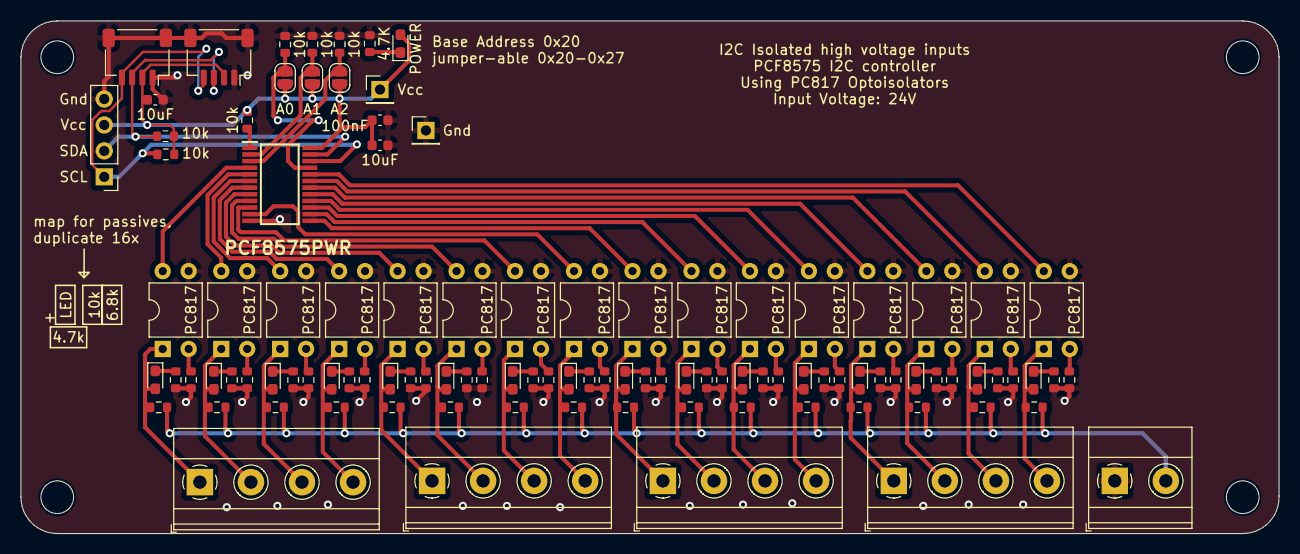
[picture p9: board i2c 24vin.kicad_pcb from above]

Board: 2 copper layers, 123.2 x 50.2 mm, 105 parts (0 on the bottom side), 74 nets.
