abzman/modular-i2c-board-set/i2c darlington/i2c darlington.kicad_pcb

## KiCad design i2c darlington/i2c darlington.kicad_pcb (2023-11-03)

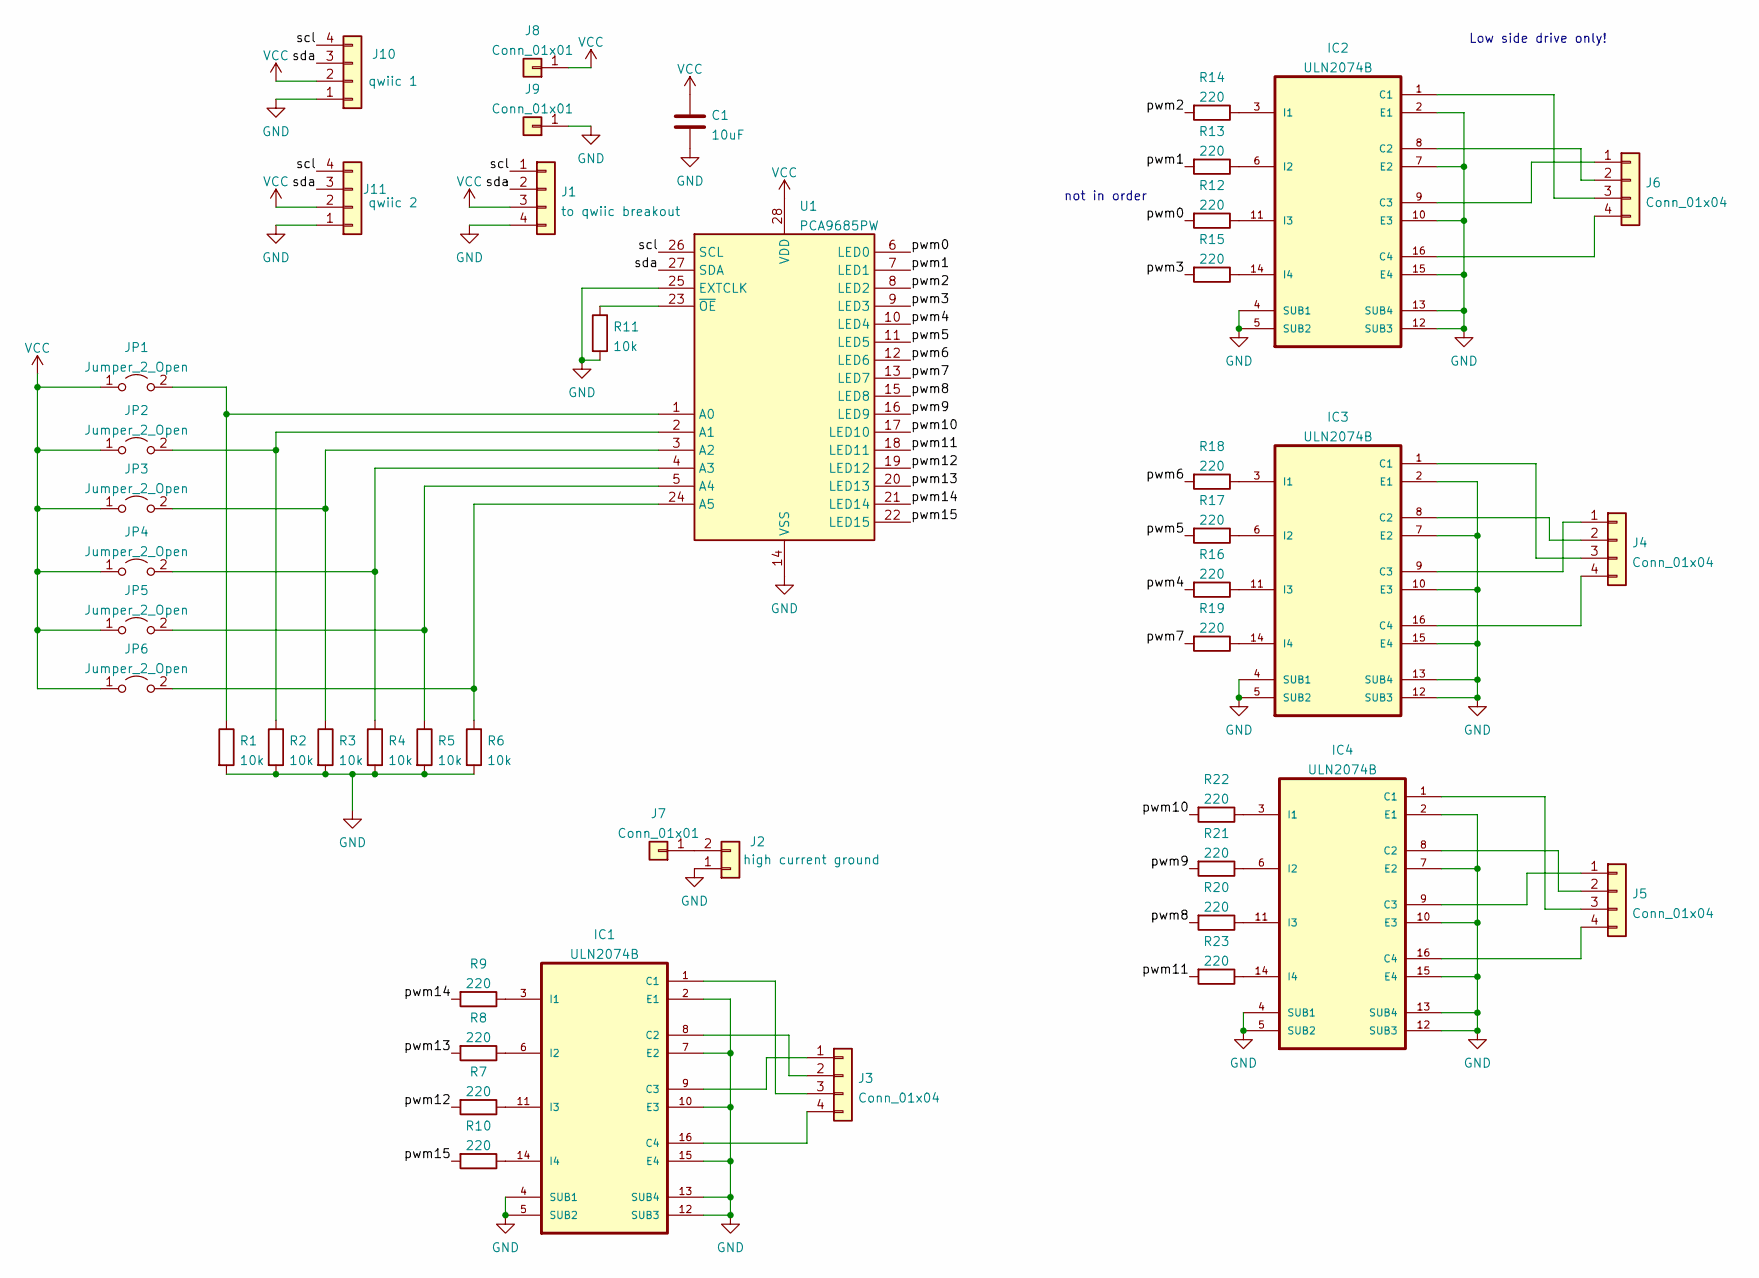
[picture p10: schematic i2c darlington.kicad_sch]

Parts:
C1: 10uF; C_0603_1608Metric
IC1, IC2, IC3, IC4: ULN2074B; DIP-16_W7.62mm
J1: to qwiic breakout; PinHeader_1x04_P2.54mm_Vertical
J2: high current ground; TerminalBlock_Phoenix_MKDS-1,5-2_1x02_P5.00mm_Horizontal
J3, J4, J5, J6: Conn_01x04; TerminalBlock_Phoenix_MKDS-1,5-4_1x04_P5.00mm_Horizontal
J7, J8, J9: Conn_01x01; PinHeader_1x01_P2.54mm_Vertical
J10: qwiic 1; JST_SH_SM04B-SRSS-TB_1x04-1MP_P1.00mm_Horizontal
J11: qwiic 2; JST_SH_SM04B-SRSS-TB_1x04-1MP_P1.00mm_Horizontal
JP1, JP2, JP3, JP4, JP5, JP6: Jumper_2_Open; SolderJumper-2_P1.3mm_Open_RoundedPad1.0x1.5mm
R1, R2, R3, R4, R5, R6, R11: 10k; R_0603_1608Metric
R7, R8, R9, R10, R12, R13, R14, R15, R16, R17, R18, R19, R20, R21, R22, R23: 220; R_0603_1608Metric
U1: PCA9685PW; TSSOP-28_4.4x9.7mm_P0.65mm

Connections:
/pwm0: R12.2, U1.6 (LED0)
/pwm1: R13.2, U1.7 (LED1)
/pwm2: R14.2, U1.8 (LED2)
/pwm3: R15.2, U1.9 (LED3)
/pwm4: R16.2, U1.10 (LED4)
/pwm5: R17.2, U1.11 (LED5)
/pwm6: R18.2, U1.12 (LED6)
/pwm7: R19.2, U1.13 (LED7)
/pwm8: R20.2, U1.15 (LED8)
/pwm9: R21.2, U1.16 (LED9)
/pwm10: R22.2, U1.17 (LED10)
/pwm11: R23.2, U1.18 (LED11)
/pwm12: R7.2, U1.19 (LED12)
/pwm13: R8.2, U1.20 (LED13)
/pwm14: R9.2, U1.21 (LED14)
/pwm15: R10.2, U1.22 (LED15)
/scl: J1.1, J10.4, J11.4, U1.26 (SCL)
/sda: J1.2, J10.3, J11.3, U1.27 (SDA)
GND: C1.2, IC1.2 (E1), IC1.4 (SUB1), IC1.5 (SUB2), IC1.7 (E2), IC1.10 (E3), IC1.12 (SUB3), IC1.13 (SUB4), IC1.15 (E4), IC2.2 (E1), IC2.4 (SUB1), IC2.5 (SUB2), IC2.7 (E2), IC2.10 (E3), IC2.12 (SUB3), IC2.13 (SUB4), IC2.15 (E4), IC3.2 (E1), IC3.4 (SUB1), IC3.5 (SUB2), IC3.7 (E2), IC3.10 (E3), IC3.12 (SUB3), IC3.13 (SUB4), IC3.15 (E4), IC4.2 (E1), IC4.4 (SUB1), IC4.5 (SUB2), IC4.7 (E2), IC4.10 (E3), IC4.12 (SUB3), IC4.13 (SUB4), IC4.15 (E4), J1.4, J2.1, J9.1, J10.1, J11.1, R1.2, R2.2, R3.2, R4.2, R5.2, R6.2, R11.2, U1.14 (VSS), U1.25 (EXTCLK)
unnamed: IC1.1 (C1), J3.3
unnamed: IC1.3 (I1), R9.1
unnamed: IC1.6 (I2), R8.1
unnamed: IC1.8 (C2), J3.2
unnamed: IC1.9 (C3), J3.1
unnamed: IC1.11 (I3), R7.1
unnamed: IC1.14 (I4), R10.1
unnamed: IC1.16 (C4), J3.4
unnamed: IC2.1 (C1), J6.3
unnamed: IC2.3 (I1), R14.1
unnamed: IC2.6 (I2), R13.1
unnamed: IC2.8 (C2), J6.2
unnamed: IC2.9 (C3), J6.1
unnamed: IC2.11 (I3), R12.1
unnamed: IC2.14 (I4), R15.1
unnamed: IC2.16 (C4), J6.4
unnamed: IC3.1 (C1), J4.3
unnamed: IC3.3 (I1), R18.1
unnamed: IC3.6 (I2), R17.1
unnamed: IC3.8 (C2), J4.2
unnamed: IC3.9 (C3), J4.1
unnamed: IC3.11 (I3), R16.1
unnamed: IC3.14 (I4), R19.1
unnamed: IC3.16 (C4), J4.4
unnamed: IC4.1 (C1), J5.3
unnamed: IC4.3 (I1), R22.1
unnamed: IC4.6 (I2), R21.1
unnamed: IC4.8 (C2), J5.2
unnamed: IC4.9 (C3), J5.1
unnamed: IC4.11 (I3), R20.1
unnamed: IC4.14 (I4), R23.1
unnamed: IC4.16 (C4), J5.4
unnamed: J2.2, J7.1
unnamed: JP1.2 (B), R1.1, U1.1 (A0)
unnamed: JP2.2 (B), R2.1, U1.2 (A1)
unnamed: JP3.2 (B), R3.1, U1.3 (A2)
unnamed: JP4.2 (B), R4.1, U1.4 (A3)
unnamed: JP5.2 (B), R5.1, U1.5 (A4)
unnamed: JP6.2 (B), R6.1, U1.24 (A5)
unnamed: R11.1, U1.23 (~OE)
VCC: C1.1, J1.3, J8.1, J10.2, J11.2, JP1.1 (A), JP2.1 (A), JP3.1 (A), JP4.1 (A), JP5.1 (A), JP6.1 (A), U1.28 (VDD)

Notes on the sheet:
Low side drive only!
not in order

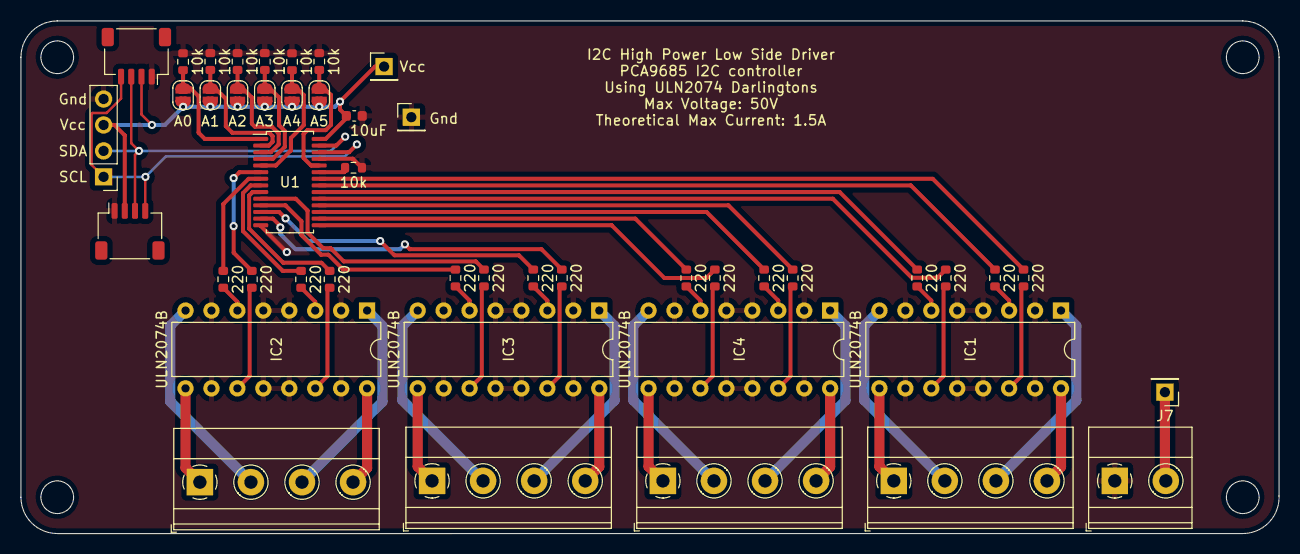
[picture p11: board i2c darlington.kicad_pcb from above]

Board: 2 copper layers, 123.2 x 50.2 mm, 46 parts (0 on the bottom side), 60 nets.
