abzman/modular-i2c-board-set/i2c l298p/i2c l298p.kicad_pcb

## KiCad design i2c l298p/i2c l298p.kicad_pcb (2023-11-03)

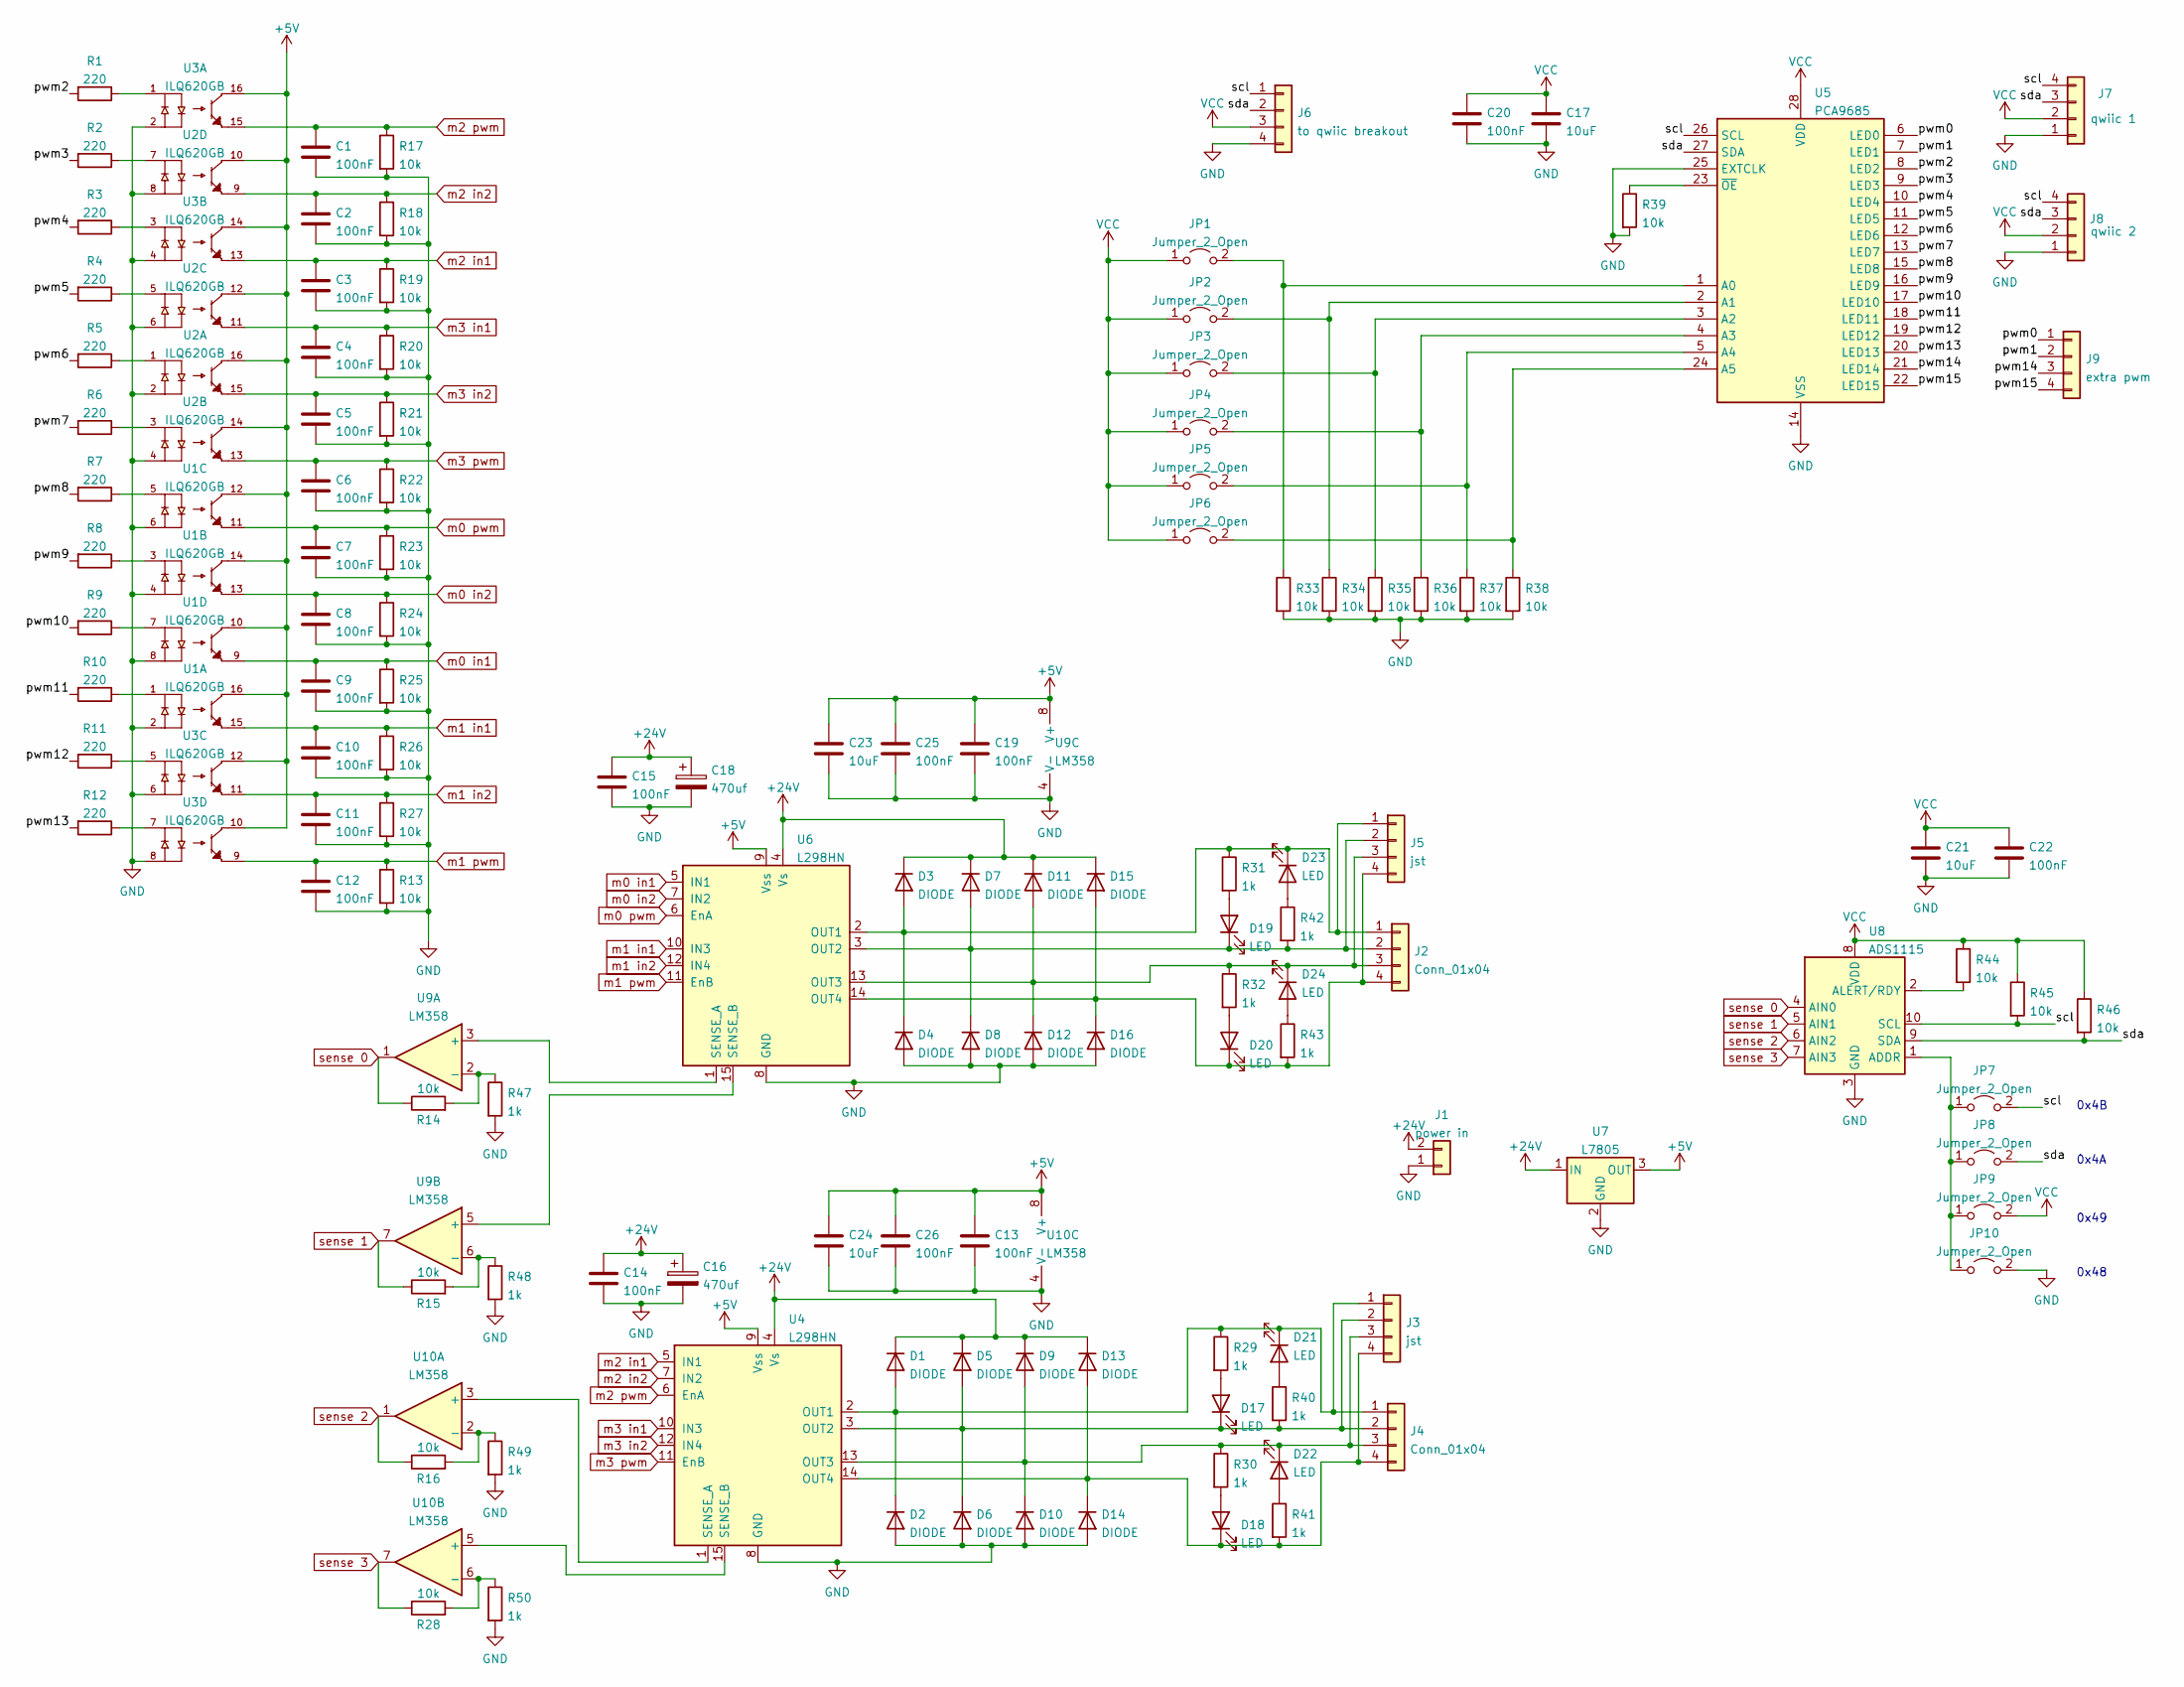
[picture p12: schematic i2c l298p.kicad_sch]

Parts:
C1, C2, C3, C4, C5, C6, C7, C8, C9, C10, C11, C12, C13, C14, C15, C19, C20, C22, C25, C26: 100nF; C_0603_1608Metric
C16, C18: 470uf; CP_Radial_D8.0mm_P3.50mm
C17, C21, C23, C24: 10uF; C_0603_1608Metric
D1, D2, D3, D4, D5, D6, D7, D8, D9, D10, D11, D12, D13, D14, D15, D16: DIODE; D_SMA
D17, D18, D19, D20, D21, D22, D23, D24: LED; LED_0603_1608Metric
J1: power in; TerminalBlock_Phoenix_MKDS-1,5-2_1x02_P5.00mm_Horizontal
J2, J4: Conn_01x04; TerminalBlock_Phoenix_MKDS-1,5-4_1x04_P5.00mm_Horizontal
J3, J5: jst; JST_XH_B4B-XH-A_1x04_P2.50mm_Vertical
J6: to qwiic breakout; PinHeader_1x04_P2.54mm_Vertical
J7: qwiic 1; JST_SH_SM04B-SRSS-TB_1x04-1MP_P1.00mm_Horizontal
J8: qwiic 2; JST_SH_SM04B-SRSS-TB_1x04-1MP_P1.00mm_Horizontal
J9: extra pwm; PinHeader_1x04_P2.54mm_Vertical
JP1, JP2, JP3, JP4, JP5, JP7, JP8, JP9, JP10: Jumper_2_Open; SolderJumper-2_P1.3mm_Open_RoundedPad1.0x1.5mm
JP6: Jumper_2_Open; SolderJumper-2_P1.3mm_Bridged_RoundedPad1.0x1.5mm
R1, R2, R3, R4, R5, R6, R7, R8, R9, R10, R11, R12: 220; R_0603_1608Metric
R13, R14, R15, R16, R17, R18, R19, R20, R21, R22, R23, R24, R25, R26, R27, R28, R33, R34, R35, R36, R37, R38, R39, R44, R45, R46: 10k; R_0603_1608Metric
R29, R30, R31, R32, R40, R41, R42, R43, R47, R48, R49, R50: 1k; R_0603_1608Metric
U1, U2, U3: ILQ620GB; OPTO_ILQ620GB-X009; PARTREV 1.8
U4, U6: L298HN; TO-220-15_P2.54x2.54mm_StaggerOdd_Lead4.58mm_Vertical
U5: PCA9685; TSSOP-28_4.4x9.7mm_P0.65mm
U7: L7805; TO-220-3_Horizontal_TabDown
U8: ADS1115; TSSOP-10_3x3mm_P0.5mm
U9, U10: LM358; SOIC-8_3.9x4.9mm_P1.27mm

Connections:
+5V: C13.1, C19.1, C23.1, C24.1, C25.1, C26.1, U1.10, U1.12, U1.14, U1.16, U2.10, U2.12, U2.14, U2.16, U3.10, U3.12, U3.14, U3.16, U4.9 (Vss), U6.9 (Vss), U7.3 (OUT), U9.8 (V+), U10.8 (V+)
+24V: C14.1, C15.1, C16.1, C18.1, D1.2 (K), D3.2 (K), D5.2 (K), D7.2 (K), D9.2 (K), D11.2 (K), D13.2 (K), D15.2 (K), J1.2, U4.4 (Vs), U6.4 (Vs), U7.1 (IN)
/pwm0: J9.1, U5.6 (LED0)
/pwm1: J9.2, U5.7 (LED1)
/pwm2: R1.2, U5.8 (LED2)
/pwm3: R2.2, U5.9 (LED3)
/pwm4: R3.2, U5.10 (LED4)
/pwm5: R4.2, U5.11 (LED5)
/pwm6: R5.2, U5.12 (LED6)
/pwm7: R6.2, U5.13 (LED7)
/pwm8: R7.2, U5.15 (LED8)
/pwm9: R8.2, U5.16 (LED9)
/pwm10: R9.2, U5.17 (LED10)
/pwm11: R10.2, U5.18 (LED11)
/pwm12: R11.2, U5.19 (LED12)
/pwm13: R12.2, U5.20 (LED13)
/pwm14: J9.3, U5.21 (LED14)
/pwm15: J9.4, U5.22 (LED15)
/scl: J6.1, J7.4, J8.4, JP7.2 (B), R45.2, U5.26 (SCL), U8.10 (SCL)
/sda: J6.2, J7.3, J8.3, JP8.2 (B), R46.2, U5.27 (SDA), U8.9 (SDA)
GND: C1.2, C2.2, C3.2, C4.2, C5.2, C6.2, C7.2, C8.2, C9.2, C10.2, C11.2, C12.2, C13.2, C14.2, C15.2, C16.2, C17.2, C18.2, C19.2, C20.2, C21.2, C22.2, C23.2, C24.2, C25.2, C26.2, D2.1 (A), D4.1 (A), D6.1 (A), D8.1 (A), D10.1 (A), D12.1 (A), D14.1 (A), D16.1 (A), J1.1, J6.4, J7.1, J8.1, JP10.2 (B), R13.2, R17.2, R18.2, R19.2, R20.2, R21.2, R22.2, R23.2, R24.2, R25.2, R26.2, R27.2, R33.2, R34.2, R35.2, R36.2, R37.2, R38.2, R39.2, R47.2, R48.2, R49.2, R50.2, U1.2, U1.4, U1.6, U1.8, U2.2, U2.4, U2.6, U2.8, U3.2, U3.4, U3.6, U3.8, U4.8 (GND), U5.14 (VSS), U5.25 (EXTCLK), U6.8 (GND), U7.2 (GND), U8.3 (GND), U9.4 (V-), U10.4 (V-)
unnamed: D1.1 (A), D2.2 (K), D21.1 (K), J3.1, J4.1, R29.1, U4.2 (OUT1)
unnamed: D9.1 (A), D10.2 (K), D22.1 (K), J3.3, J4.3, R30.1, U4.13 (OUT3)
unnamed: D11.1 (A), D12.2 (K), D24.1 (K), J2.3, J5.3, R32.1, U6.13 (OUT3)
unnamed: D13.1 (A), D14.2 (K), D18.1 (K), J3.4, J4.4, R41.2, U4.14 (OUT4)
unnamed: D15.1 (A), D16.2 (K), D20.1 (K), J2.4, J5.4, R43.2, U6.14 (OUT4)
unnamed: D5.1 (A), D6.2 (K), D17.1 (K), J3.2, J4.2, R40.2, U4.3 (OUT2)
unnamed: D17.2 (A), R29.2
unnamed: D18.2 (A), R30.2
unnamed: D7.1 (A), D8.2 (K), D19.1 (K), J2.2, J5.2, R42.2, U6.3 (OUT2)
unnamed: D19.2 (A), R31.2
unnamed: D20.2 (A), R32.2
unnamed: D21.2 (A), R40.1
unnamed: D22.2 (A), R41.1
unnamed: D3.1 (A), D4.2 (K), D23.1 (K), J2.1, J5.1, R31.1, U6.2 (OUT1)
unnamed: D23.2 (A), R42.1
unnamed: D24.2 (A), R43.1
unnamed: JP1.2 (B), R33.1, U5.1 (A0)
unnamed: JP2.2 (B), R34.1, U5.2 (A1)
unnamed: JP3.2 (B), R35.1, U5.3 (A2)
unnamed: JP4.2 (B), R36.1, U5.4 (A3)
unnamed: JP5.2 (B), R37.1, U5.5 (A4)
unnamed: JP6.2 (B), R38.1, U5.24 (A5)
unnamed: JP7.1 (A), JP8.1 (A), JP9.1 (A), JP10.1 (A), U8.1 (ADDR)
unnamed: R1.1, U3.1
unnamed: R2.1, U2.7
unnamed: R3.1, U3.3
unnamed: R4.1, U2.5
unnamed: R5.1, U2.1
unnamed: R6.1, U2.3
unnamed: R7.1, U1.5
unnamed: R8.1, U1.3
unnamed: R9.1, U1.7
unnamed: R10.1, U1.1
unnamed: R11.1, U3.5
unnamed: R12.1, U3.7
unnamed: R14.2, R47.1, U9.2 (-)
unnamed: R15.2, R48.1, U9.6 (-)
unnamed: R16.2, R49.1, U10.2 (-)
unnamed: R28.2, R50.1, U10.6 (-)
unnamed: R39.1, U5.23 (~OE)
unnamed: R44.2, U8.2 (ALERT/RDY)
unnamed: U6.1 (SENSE_A), U9.3 (+)
unnamed: U6.15 (SENSE_B), U9.5 (+)
unnamed: U4.1 (SENSE_A), U10.3 (+)
unnamed: U4.15 (SENSE_B), U10.5 (+)
VCC: C17.1, C20.1, C21.1, C22.1, J6.3, J7.2, J8.2, JP1.1 (A), JP2.1 (A), JP3.1 (A), JP4.1 (A), JP5.1 (A), JP6.1 (A), JP9.2 (B), R44.1, R45.1, R46.1, U5.28 (VDD), U8.8 (VDD)
m0 in1: C9.1, R25.1, U1.9, U6.5 (IN1)
m0 in2: C8.1, R24.1, U1.13, U6.7 (IN2)
m0 pwm: C7.1, R23.1, U1.11, U6.6 (EnA)
m1 in1: C10.1, R26.1, U1.15, U6.10 (IN3)
m1 in2: C11.1, R27.1, U3.11, U6.12 (IN4)
m1 pwm: C12.1, R13.1, U3.9, U6.11 (EnB)
m2 in1: C3.1, R19.1, U3.13, U4.5 (IN1)
m2 in2: C2.1, R18.1, U2.9, U4.7 (IN2)
m2 pwm: C1.1, R17.1, U3.15, U4.6 (EnA)
m3 in1: C4.1, R20.1, U2.11, U4.10 (IN3)
m3 in2: C5.1, R21.1, U2.15, U4.12 (IN4)
m3 pwm: C6.1, R22.1, U2.13, U4.11 (EnB)
sense 0: R14.1, U8.4 (AIN0), U9.1
sense 1: R15.1, U8.5 (AIN1), U9.7
sense 2: R16.1, U8.6 (AIN2), U10.1
sense 3: R28.1, U8.7 (AIN3), U10.7

Notes on the sheet:
0x48
0x4A
0x49
0x4B

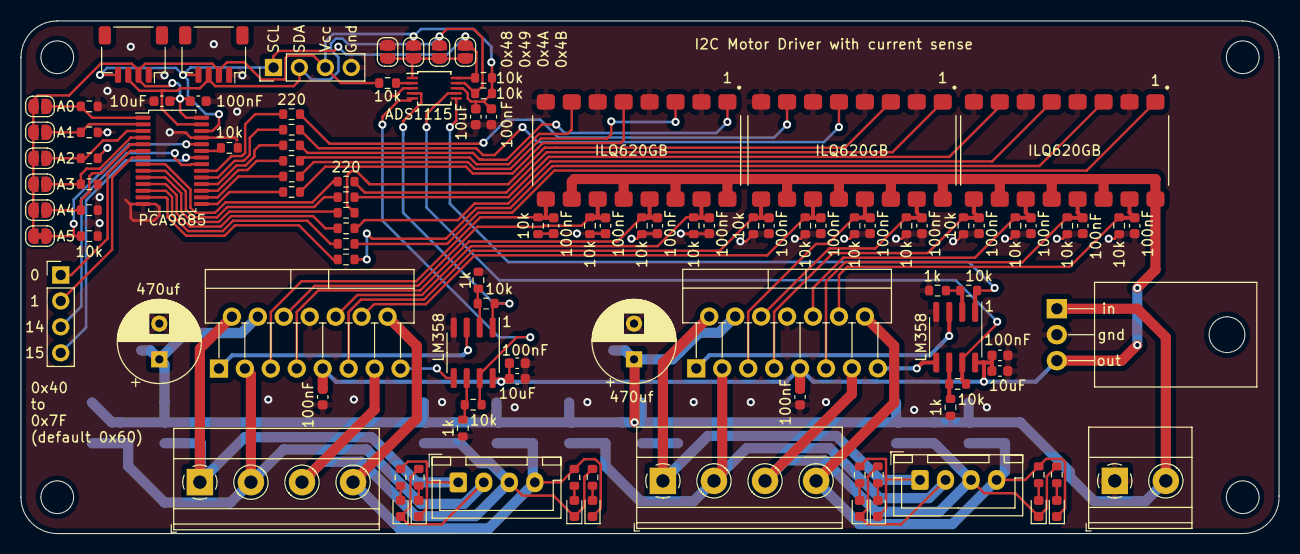
[picture p13: board i2c l298p.kicad_pcb from above]

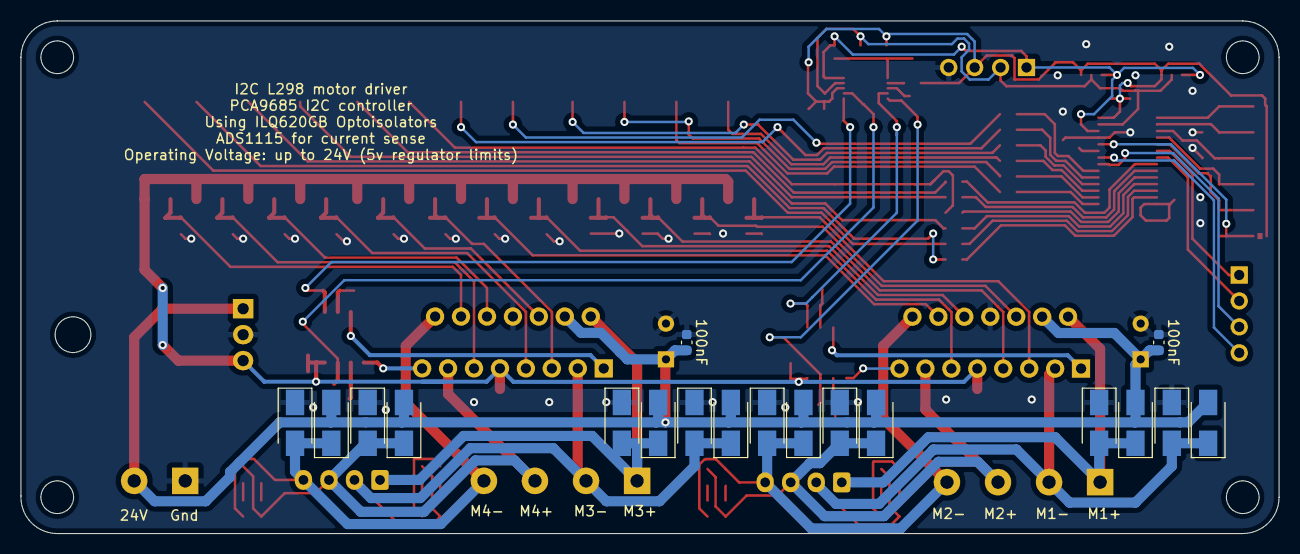
[picture p14: board i2c l298p.kicad_pcb from below]

Board: 2 copper layers, 123.2 x 50.2 mm, 129 parts (18 on the bottom side), 83 nets.
