abzman/modular-i2c-board-set/rp2040 rs485 scale breakout/rp2040 rs485 scale breakout.kicad_pcb

## KiCad design rp2040 rs485 scale breakout/rp2040 rs485 scale breakout.kicad_pcb (2023-11-03)

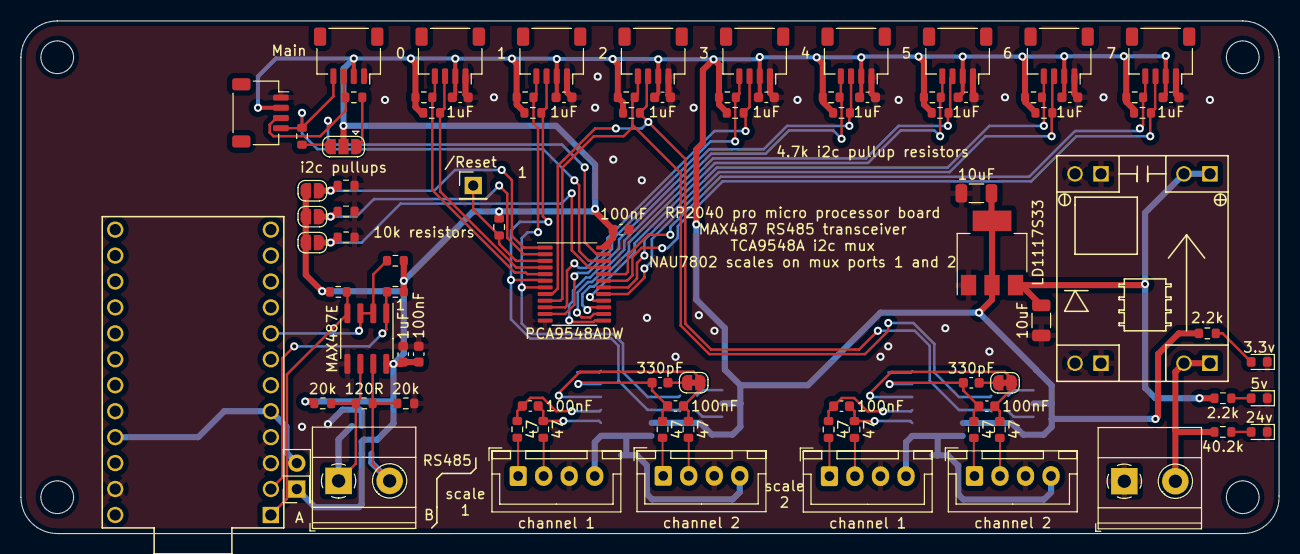
[picture p15: board rp2040 rs485 scale breakout.kicad_pcb from above]

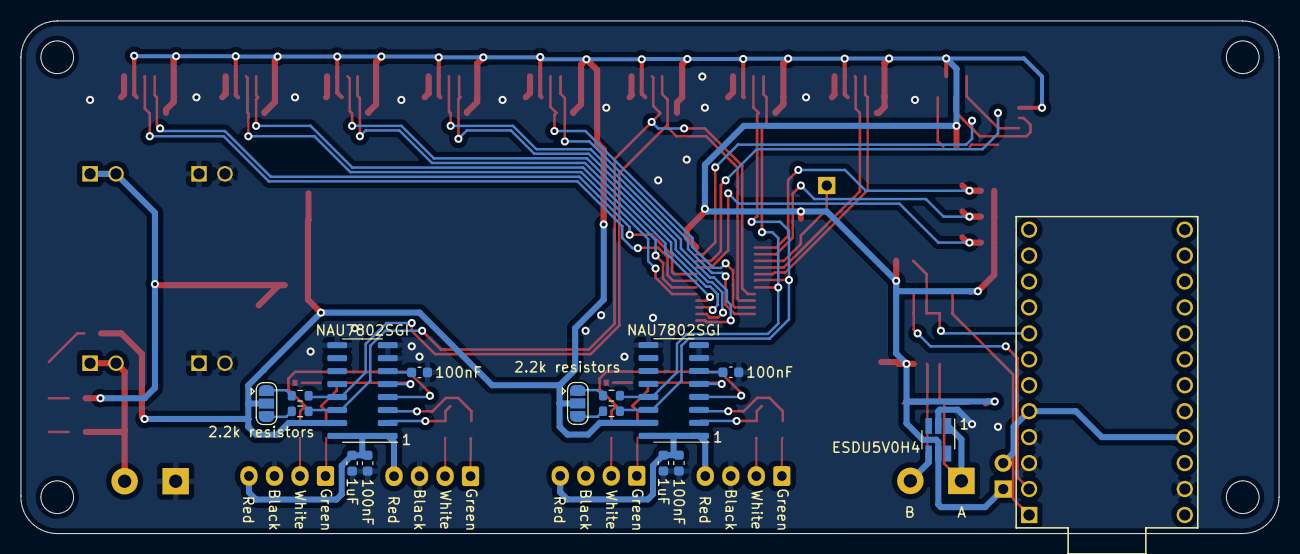
[picture p16: board rp2040 rs485 scale breakout.kicad_pcb from below]

Board: 2 copper layers, 123.2 x 50.2 mm, 105 parts (15 on the bottom side), 63 nets.

Parts:
C1, C4, C5, C6, C7, C8, C9, C10, C11, C16, C21: 1uF; C_0603_1608Metric
C2, C3, C13, C14, C15, C18, C19, C20, C22, C23: 100nF; C_0603_1608Metric
C12, C17: 330pF; C_0603_1608Metric
C24, C25: 10uF; C_1206_3216Metric
D1: 24v; LED_0603_1608Metric
D2: 5v; LED_0603_1608Metric
D3: 3.3v; LED_0603_1608Metric
J1: main i2c; JST_SH_SM04B-SRSS-TB_1x04-1MP_P1.00mm_Horizontal
J2: ESDU5V0H4; SOT-23-6_Handsoldering
J3: rs485; TerminalBlock_Phoenix_MKDS-1,5-2_1x02_P5.00mm_Horizontal
J4: Conn_01x01; PinHeader_1x01_P2.54mm_Vertical
J5: i2c pullups; SolderJumper-3_P1.3mm_Open_RoundedPad1.0x1.5mm
J6: qwiic from pro micro; JST_SH_SM04B-SRSS-TB_1x04-1MP_P1.00mm_Horizontal
J7: i2c 5; JST_SH_SM04B-SRSS-TB_1x04-1MP_P1.00mm_Horizontal
J8: i2c 6; JST_SH_SM04B-SRSS-TB_1x04-1MP_P1.00mm_Horizontal
J9: i2c 7; JST_SH_SM04B-SRSS-TB_1x04-1MP_P1.00mm_Horizontal
J10: i2c 3; JST_SH_SM04B-SRSS-TB_1x04-1MP_P1.00mm_Horizontal
J11: i2c 4; JST_SH_SM04B-SRSS-TB_1x04-1MP_P1.00mm_Horizontal
J12: i2c 2; JST_SH_SM04B-SRSS-TB_1x04-1MP_P1.00mm_Horizontal
J13: i2c 0; JST_SH_SM04B-SRSS-TB_1x04-1MP_P1.00mm_Horizontal
J14: i2c 1; JST_SH_SM04B-SRSS-TB_1x04-1MP_P1.00mm_Horizontal
J15, J19: channel 1; JST_XH_B4B-XH-A_1x04_P2.50mm_Vertical
J16, J20: channel 2; JST_XH_B4B-XH-A_1x04_P2.50mm_Vertical
J17, J21: cap; SolderJumper-2_P1.3mm_Bridged_RoundedPad1.0x1.5mm
J18, J22: i2c pullips; SolderJumper-3_P1.3mm_Open_RoundedPad1.0x1.5mm
J23: power in; TerminalBlock_Phoenix_MKDS-1,5-2_1x02_P5.00mm_Horizontal
J24: Conn_01x02; PinHeader_2x01_P2.54mm_Vertical
JP1, JP2, JP3: Jumper_2_Open; SolderJumper-2_P1.3mm_Open_RoundedPad1.0x1.5mm
R1, R2, R3, R4, R8, R9, R10: 10k; R_0603_1608Metric
R5, R7: 20k; R_0603_1608Metric
R6: 120R; R_0603_1608Metric
R11, R12, R13, R14, R15, R16, R17, R18, R19, R20, R21, R22, R23, R24, R25, R26, R27, R28: 4.7k; R_0603_1608Metric
R29, R30, R33, R34, R37, R38, R39, R40: 47; R_0603_1608Metric
R31, R32, R35, R36, R42, R43: 2.2k; R_0603_1608Metric
R41: 40.2k; R_0603_1608Metric
U1: MAX487E; SOIC-8_3.9x4.9mm_P1.27mm
U2: ProMicro_2040; ProMicro
U3: PCA9548ADW; TSSOP-24_4.4x7.8mm_P0.65mm
U4, U5: NAU7802SGI; SOIC-16_3.9x9.9mm_P1.27mm
U6: mp1584 dcdc; MP1584_buck_module
U7: LD1117S33; SOT-223-3_TabPin2

Connections:
485 direction: R2.2, U1.2 (~RE), U1.3 (DE), U2.8 (5)
+3V3: C1.1, C2.1, C3.1, C4.1, C5.1, C6.1, C7.1, C8.1, C9.1, C10.1, C11.1, C25.1, J1.2, J2.5, J5.2, J6.2, J7.2, J8.2, J9.2, J10.2, J11.2, J12.2, J13.2, J14.2, J18.2, J22.2, J24.1, JP1.1 (A), JP2.1 (A), JP3.1 (A), R1.1, R2.1, R3.1, R7.2, R10.1, R13.1, R14.1, R15.1, R16.1, R17.1, R18.1, R19.1, R20.1, R21.1, R22.1, R23.1, R24.1, R25.1, R26.1, R27.1, R28.1, R43.1, U1.8 (VCC), U3.24 (VCC), U4.15 (DVDD), U5.15 (DVDD), U7.2 (VO)
+5V: C24.1, R42.1, U6.4, U7.3 (VI)
+24V: J23.2, R41.1, U6.1
/nau7802 module1/A+: J19.1, R34.1
/nau7802 module1/A-: J19.2, R33.1
/nau7802 module1/B+: J20.1, R40.1
/nau7802 module1/B-: J20.2, R39.1
/nau7802 module/A+: J15.1, R30.1
/nau7802 module/A-: J15.2, R29.1
/nau7802 module/B+: J16.1, R38.1
/nau7802 module/B-: J16.2, R37.1
A: J2.1, J3.1, R6.2, R7.1, U1.6 (A)
A0: JP1.2 (B), R4.1, U3.1 (A0)
A1: JP2.2 (B), R8.1, U3.2 (A1)
A2: JP3.2 (B), R9.1, U3.21 (A2)
B: J2.4, J3.2, R5.2, R6.1, U1.7 (B)
GND: C1.2, C2.2, C3.2, C4.2, C5.2, C6.2, C7.2, C8.2, C9.2, C10.2, C11.2, C14.2, C15.2, C16.2, C19.2, C20.2, C21.2, C24.2, C25.2, D1.1 (K), D2.1 (K), D3.1 (K), J1.1, J2.2, J6.1, J7.1, J8.1, J9.1, J10.1, J11.1, J12.1, J13.1, J14.1, J15.3, J16.3, J19.3, J20.3, J23.1, R4.2, R5.1, R8.2, R9.2, U1.5 (GND), U2.3 (GND), U2.4 (GND), U2.23 (GND), U3.12 (GND), U4.7 (REFN), U4.8 (AVSS), U4.9 (DVSS), U5.7 (REFN), U5.8 (AVSS), U5.9 (DVSS), U6.2, U6.3, U7.1 (GND)
Main_SCL: J1.4, J6.4, R11.2, U3.22 (SCL)
Main_SDA: J1.3, J6.3, R12.2, U3.23 (SDA)
unnamed: C12.1, J17.1
unnamed: C12.2, C22.2, R38.2, U4.5 (VIN2P)
unnamed: C13.1, R29.2, U4.2 (VIN1N)
unnamed: C13.2, R30.2, U4.3 (VIN1P)
unnamed: C14.1, U4.6 (VBG)
unnamed: C15.1, C16.1, J15.4, J16.4, U4.1 (REFP), U4.16 (AVDD/LDO)
unnamed: C17.1, J21.1
unnamed: C17.2, C23.2, R40.2, U5.5 (VIN2P)
unnamed: C18.1, R33.2, U5.2 (VIN1N)
unnamed: C18.2, R34.2, U5.3 (VIN1P)
unnamed: C19.1, U5.6 (VBG)
unnamed: C20.1, C21.1, J19.4, J20.4, U5.1 (REFP), U5.16 (AVDD/LDO)
unnamed: C22.1, J17.2, R37.2, U4.4 (VIN2N)
unnamed: C23.1, J21.2, R39.2, U5.4 (VIN2N)
unnamed: D1.2 (A), R41.2
unnamed: D2.2 (A), R42.2
unnamed: D3.2 (A), R43.2
unnamed: J4.1, R10.2, U3.3 (~RESET)
unnamed: J5.1, R12.1
unnamed: J5.3, R11.1
unnamed: J18.1, R31.1
unnamed: J18.3, R32.1
unnamed: J22.1, R35.1
unnamed: J22.3, R36.1
unnamed: J24.2, U2.5 (2), U2.21 (3.3v)
Rx: R3.2, U1.1 (RO), U2.2 (RX)
SCL0: J13.4, R22.2, U3.5 (SC0)
SCL1: J14.4, R23.2, R31.2, U3.7 (SC1), U4.13 (SCLK)
SCL2: J12.4, R21.2, R35.2, U3.9 (SC2), U5.13 (SCLK)
SCL3: J10.4, R19.2, U3.11 (SC3)
SCL4: J11.4, R20.2, U3.14 (SC4)
SCL5: J7.4, R13.2, U3.16 (SC5)
SCL6: J8.4, R14.2, U3.18 (SC6)
SCL7: J9.4, R15.2, U3.20 (SC7)
SDA0: J13.3, R27.2, U3.4 (SD0)
SDA1: J14.3, R28.2, R32.2, U3.6 (SD1), U4.14 (SDIO)
SDA2: J12.3, R26.2, R36.2, U3.8 (SD2), U5.14 (SDIO)
SDA3: J10.3, R24.2, U3.10 (SD3)
SDA4: J11.3, R25.2, U3.13 (SD4)
SDA5: J7.3, R16.2, U3.15 (SD5)
SDA6: J8.3, R17.2, U3.17 (SD6)
SDA7: J9.3, R18.2, U3.19 (SD7)
Tx: R1.2, U1.4 (DI), U2.1 (TX)
