abzman/modular-i2c-board-set/test programs/Bounce_augmented/Bounce_augmented.ino

// Bounce.pde
// -*- mode: C++ -*-
//
// Make a single stepper bounce from one limit to another
//
// Copyright (C) 2012 Mike McCauley
// $Id: Random.pde,v 1.1 2011/01/05 01:51:01 mikem Exp mikem $


// Define a stepper and the pins it will use
//AccelStepper stepper; // Defaults to AccelStepper::FULL4WIRE (4 pins) on 2, 3, 4, 5

  
#include <AccelStepper.h>

  AccelStepper stepper(1, 7, 6); // Defaults to AccelStepper::FULL4WIRE (4 pins) on 2, 3, 4, 5




void setup()
{

  Serial.begin(115200);
  Serial.println("accelstepper test");
  // Change these to suit your stepper if you want








  stepper.setMaxSpeed(600);
  stepper.setAcceleration(100);
  stepper.moveTo(500);



}

void loop()
{
    // If at the end of travel go to the other end
    if (stepper.distanceToGo() == 0)
      stepper.moveTo(-stepper.currentPosition());

    stepper.run();
}
