abzman/modular-i2c-board-set/test programs/dumb_i2c_scanner/dumb_i2c_scanner.ino

#include <Wire.h>

void setup() {

  Serial.begin(115200);
  delay(5000);
  Serial.println();
  Serial.println("i2c Read Example");

  Wire.begin();

}
void loop() {

  Serial.println("Begin scanning for I2C devices");

  byte nDevices = 0;
  for (byte address = 1; address < 127; address++)
  {
    Wire.beginTransmission(address);
    byte error = Wire.endTransmission();

    if (error == 0)
    {
      Serial.print("I2C device found at address 0x");
      if (address < 0x10)
        Serial.print("0");
      Serial.print(address, HEX);
      Serial.println();

      nDevices++;
    }
    else if (error == 4)
    {
      Serial.print("Unknown error at address 0x");
      if (address < 0x10)
        Serial.print("0");
      Serial.println(address, HEX);
    }
  }

  if (nDevices == 0)
    Serial.println("No I2C devices found");
  else
    Serial.println("Done");
  delay(1000);
}
