abzman/modular-i2c-board-set/(commit log)

2023-11-03 moved contents from other repo
    https://github.com/abzman/small-useful-PCBs
    [bts7960module.kicad_sch, bts7960module2.kicad_sch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]
2024-04-10 DFM 24vin
    [i2c 24vin.kicad_pcb]
2024-04-10 DFM 24vout
    [i2c 24vout.kicad_pcb]
2024-04-11 motor controller DFM
    [bts7960module.kicad_sch, bts7960module2.kicad_sch, i2c BTS7960.kicad_pcb, i2c BTS7960.kicad_sch]
